schwabix-1311/aquaPCB/fab/aquaPCB-bom-jlc.csv

Comment | Designator | Footprint | LCSC Part #
4u7 50V | C2,C3 | C_1206_3216Metric | C29823
100n | C4,C5,C12,C13,C20,C21,C22,C23 | C_0805_2012Metric | C49678
10n | C6 | C_0805_2012Metric | C1710
47p | C7 | C_0805_2012Metric | C14857
47u | C8,C9 | C_1206_3216Metric | C96123
10u | C10,C11,C18,C19,C24,C25,C27,C28 | C_0805_2012Metric | C15850
BZT52C15 | D1 | D_SOD-123 | C173427
SMBJ33A | D2 | D_SMB | C78419
PWR | D3 | LED_0805_2012Metric | C84256
SS54 | D4,D6,D8,D10,D12,D14,D16 | D_SMA | C22452
3V3 | D5 | LED_0805_2012Metric | C2297
GPIO18 | D7 | LED_0805_2012Metric | C2297
PCA#1 ch15 | D9 | LED_0805_2012Metric | C2297
PCA#1 ch14 | D11 | LED_0805_2012Metric | C2297
GPIO19 | D13 | LED_0805_2012Metric | C2297
PCA#1 ch13 | D15 | LED_0805_2012Metric | C2297
PCA#1 ch12 | D17 | LED_0805_2012Metric | C2297
BAT54S | D26,D27,D28,D29,D30,D31,D32,D33,D34,D35,D36 | SOT-23 | C12765
10A | F1 | Littelfuse_OMNI-BLOK_154 | C206921
PTC 1.1A | F2 | Fuse_1206_3216Metric | C71465
10uH 4.8A | L1 | L_TDK_SLF12565 | C138303
AOD4184A | Q1,Q2,Q3,Q4,Q5,Q6 | TO-252-2 | C99124
DMP4010SK3Q | Q10 | TO-252-2 | C5359358
10k | R1,R2,R8,R9,R10,R11,R12,R13,R15,R18,R21,R24,R27,R30,R50,R52,R64,R66 | R_0805_2012Metric | C17414
150k | R3 | R_0805_2012Metric | C17470
12k | R4,R5 | R_0805_2012Metric | C17444
2k2 | R6 | R_0805_2012Metric | C17520
1k | R7,R16,R19,R22,R25,R28,R31,R55,R56,R57,R58,R59,R60 | R_0805_2012Metric | C17513
100 | R14,R17,R20,R23,R26,R29 | R_0805_2012Metric | C17408
4k7 | R44 | R_0805_2012Metric | C17673
20k | R51,R65,R67,R68 | R_0805_2012Metric | C4328
10k | R53,R54 | R_0603_1608Metric | C25804
4x100 | RN1,RN2,RN3,RN4,RN5,RN6,RN7,RN8 | R_Array_Convex_4x0603 | C25506
TPS54360B | U1 | TI_SO-PowerPAD-8_ThermalVias | C524806
AMS1117-3.3 | U2,U11 | SOT-223-3_TabPin2 | C6186
74HCT244D | U3 | SOIC-20W_7.5x12.8mm_P1.27mm | C5978
ADS1115IDGSR | U5 | TSSOP-10_3x3mm_P0.5mm | C37593
PCA9685PW | U7,U10 | TSSOP-28_4.4x9.7mm_P0.65mm | C2678753
74HCT244PW | U8,U9 | TSSOP-20_4.4x6.5mm_P0.65mm | C131088
