schwabix-1311/aquaPCB/fab/aquaPCB-print-1to1.pdf

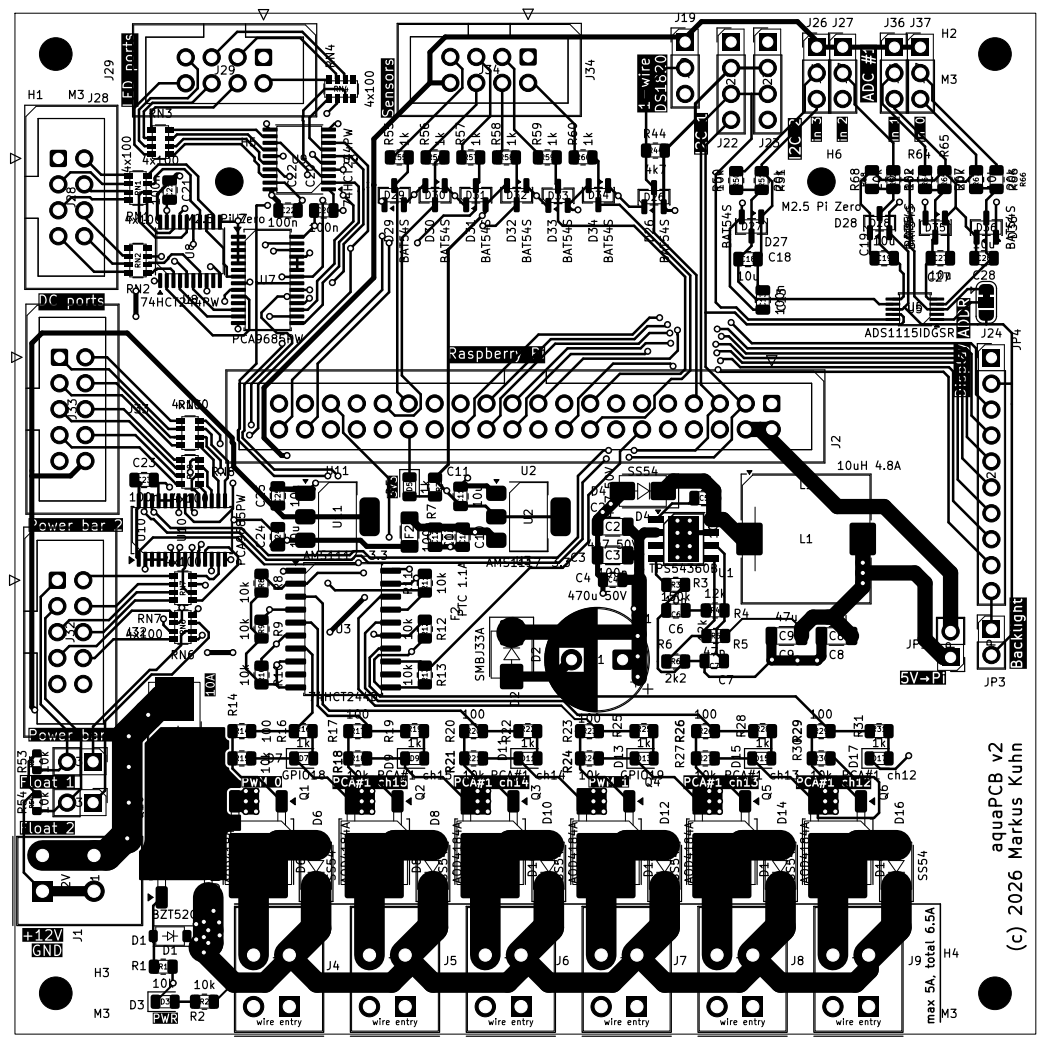
[picture p1: page 1]

max 5A, total 6.5A aquaPCB v2 (c) 2026 Markus Kuhn Q1 R1 R25 D15 R22 R2 R7 J34 R59 RN3 D10J31 H3 D13 R57 C21 D7 D12 U11 C20 Q5
