schwabix-1311/aquaPCB/kicad/aquaPCB.kicad_pcb

## KiCad design kicad/aquaPCB.kicad_pcb (2026-10-26)

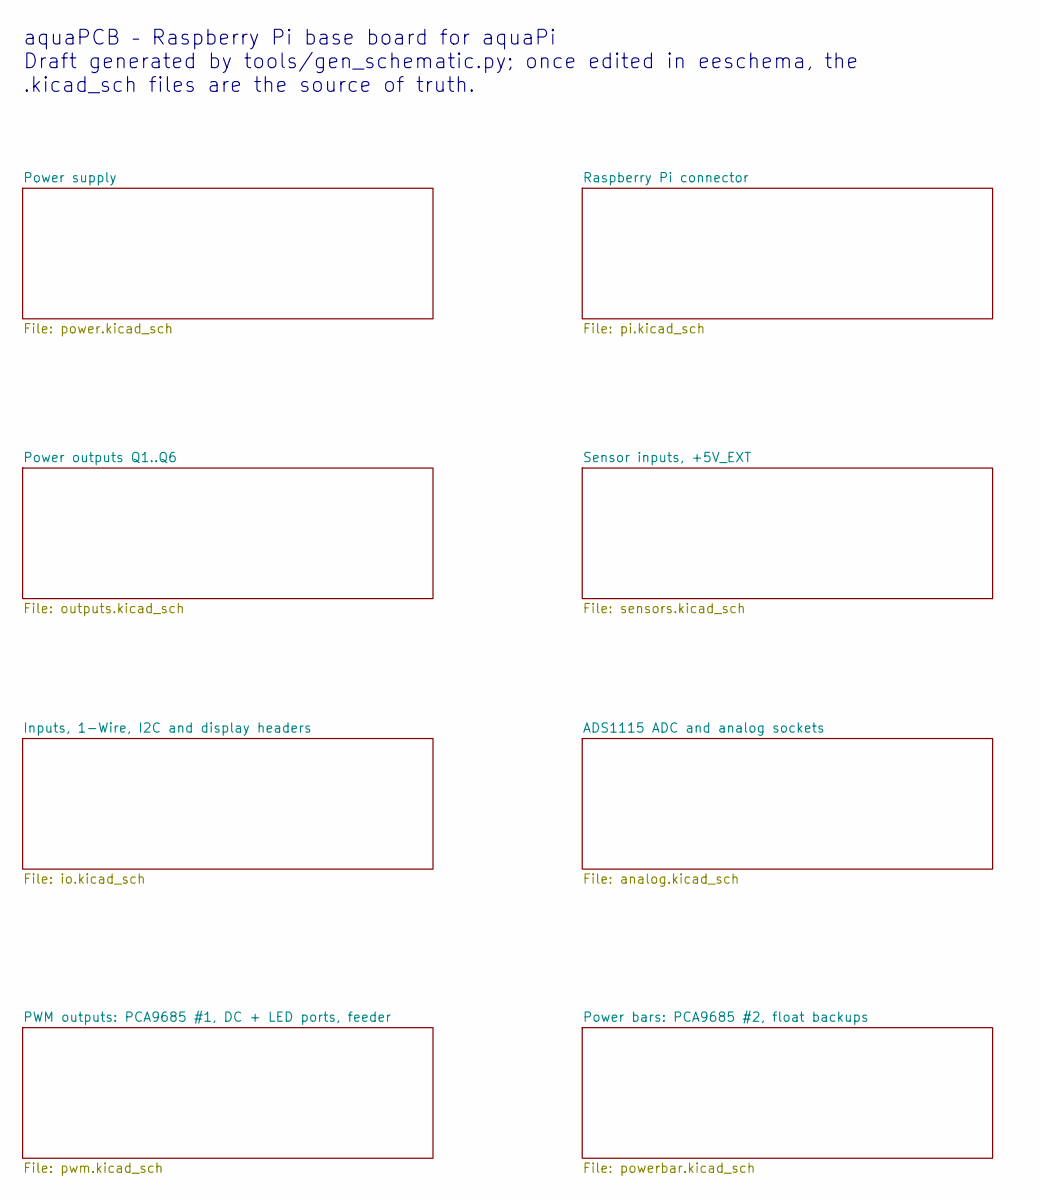
[picture p2: schematic aquaPCB.kicad_sch, aquaPCB – Overview]

Notes on the sheet:
aquaPCB – Raspberry Pi base board for aquaPi Draft generated by tools/gen_schematic.py; once edited in eeschema, the .kicad_sch files are the source of truth.

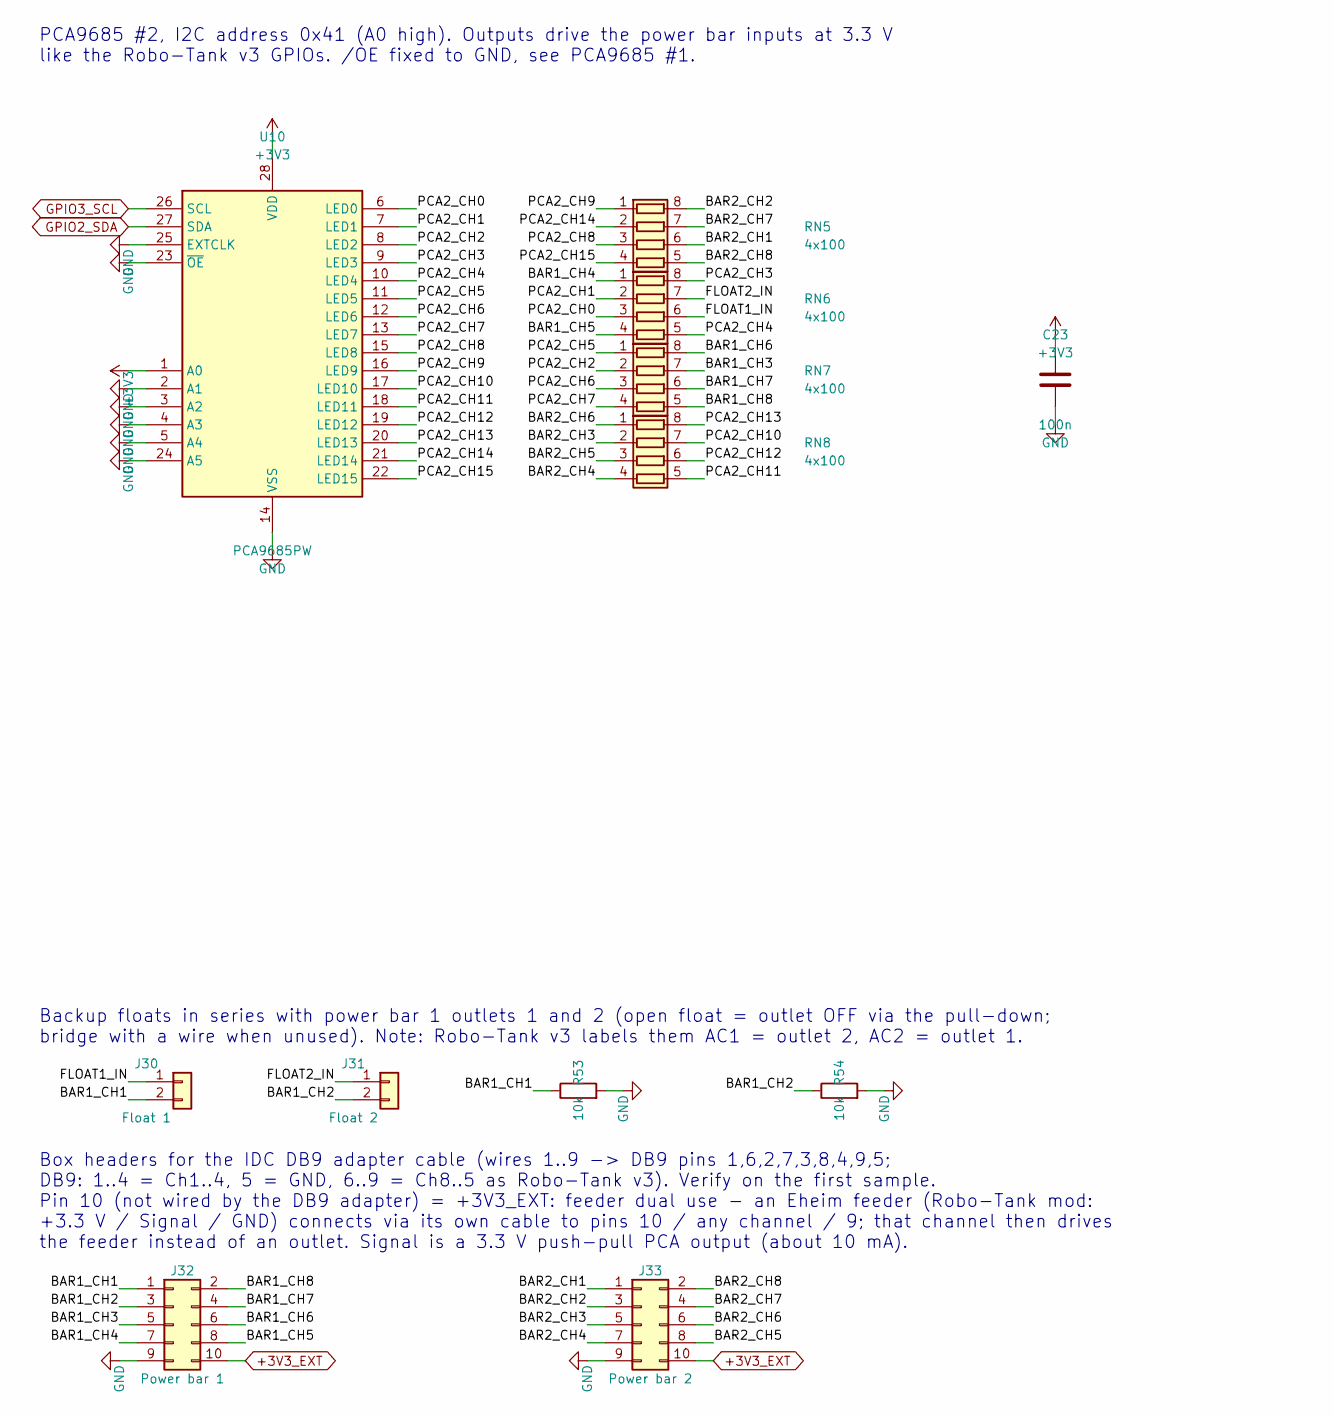
[picture p3: schematic powerbar.kicad_sch, aquaPCB – Power bars: PCA9685 #2, float backups]

Parts:
C23: 100n; C_0805_2012Metric; LCSC C49678
J30: Float 1; PinHeader_1x02_P2.54mm_Vertical
J31: Float 2; PinHeader_1x02_P2.54mm_Vertical
J32: Power bar 1; IDC-Header_2x05_P2.54mm_Vertical
J33: Power bar 2; IDC-Header_2x05_P2.54mm_Vertical
R53, R54: 10k; R_0603_1608Metric; LCSC C25804
RN5, RN6, RN7, RN8: 4x100; R_Array_Convex_4x0603; LCSC C25506
U10: PCA9685PW; TSSOP-28_4.4x9.7mm_P0.65mm; LCSC C2678753

Connections:
+3V3: C23.1, U10.1 (A0), U10.28 (VDD); also elsewhere on the board
+3V3_EXT: J32.10, J33.10; also elsewhere on the board
/Power bars: PCA9685 #2, float backups/BAR1_CH1: J30.2, J32.1, R53.1
/Power bars: PCA9685 #2, float backups/BAR1_CH2: J31.2, J32.3, R54.1
/Power bars: PCA9685 #2, float backups/BAR1_CH3: J32.5, RN7.7 (R2.2)
/Power bars: PCA9685 #2, float backups/BAR1_CH4: J32.7, RN6.1 (R1.1)
/Power bars: PCA9685 #2, float backups/BAR1_CH5: J32.8, RN6.4 (R4.1)
/Power bars: PCA9685 #2, float backups/BAR1_CH6: J32.6, RN7.8 (R1.2)
/Power bars: PCA9685 #2, float backups/BAR1_CH7: J32.4, RN7.6 (R3.2)
/Power bars: PCA9685 #2, float backups/BAR1_CH8: J32.2, RN7.5 (R4.2)
/Power bars: PCA9685 #2, float backups/BAR2_CH1: J33.1, RN5.6 (R3.2)
/Power bars: PCA9685 #2, float backups/BAR2_CH2: J33.3, RN5.8 (R1.2)
/Power bars: PCA9685 #2, float backups/BAR2_CH3: J33.5, RN8.2 (R2.1)
/Power bars: PCA9685 #2, float backups/BAR2_CH4: J33.7, RN8.4 (R4.1)
/Power bars: PCA9685 #2, float backups/BAR2_CH5: J33.8, RN8.3 (R3.1)
/Power bars: PCA9685 #2, float backups/BAR2_CH6: J33.6, RN8.1 (R1.1)
/Power bars: PCA9685 #2, float backups/BAR2_CH7: J33.4, RN5.7 (R2.2)
/Power bars: PCA9685 #2, float backups/BAR2_CH8: J33.2, RN5.5 (R4.2)
/Power bars: PCA9685 #2, float backups/FLOAT1_IN: J30.1, RN6.6 (R3.2)
/Power bars: PCA9685 #2, float backups/FLOAT2_IN: J31.1, RN6.7 (R2.2)
/Power bars: PCA9685 #2, float backups/PCA2_CH0: RN6.3 (R3.1), U10.6 (LED0)
/Power bars: PCA9685 #2, float backups/PCA2_CH1: RN6.2 (R2.1), U10.7 (LED1)
/Power bars: PCA9685 #2, float backups/PCA2_CH2: RN7.2 (R2.1), U10.8 (LED2)
/Power bars: PCA9685 #2, float backups/PCA2_CH3: RN6.8 (R1.2), U10.9 (LED3)
/Power bars: PCA9685 #2, float backups/PCA2_CH4: RN6.5 (R4.2), U10.10 (LED4)
/Power bars: PCA9685 #2, float backups/PCA2_CH5: RN7.1 (R1.1), U10.11 (LED5)
/Power bars: PCA9685 #2, float backups/PCA2_CH6: RN7.3 (R3.1), U10.12 (LED6)
/Power bars: PCA9685 #2, float backups/PCA2_CH7: RN7.4 (R4.1), U10.13 (LED7)
/Power bars: PCA9685 #2, float backups/PCA2_CH8: RN5.3 (R3.1), U10.15 (LED8)
/Power bars: PCA9685 #2, float backups/PCA2_CH9: RN5.1 (R1.1), U10.16 (LED9)
/Power bars: PCA9685 #2, float backups/PCA2_CH10: RN8.7 (R2.2), U10.17 (LED10)
/Power bars: PCA9685 #2, float backups/PCA2_CH11: RN8.5 (R4.2), U10.18 (LED11)
/Power bars: PCA9685 #2, float backups/PCA2_CH12: RN8.6 (R3.2), U10.19 (LED12)
/Power bars: PCA9685 #2, float backups/PCA2_CH13: RN8.8 (R1.2), U10.20 (LED13)
/Power bars: PCA9685 #2, float backups/PCA2_CH14: RN5.2 (R2.1), U10.21 (LED14)
/Power bars: PCA9685 #2, float backups/PCA2_CH15: RN5.4 (R4.1), U10.22 (LED15)
GND: C23.2, J32.9, J33.9, R53.2, R54.2, U10.2 (A1), U10.3 (A2), U10.4 (A3), U10.5 (A4), U10.14 (VSS), U10.23 (~OE), U10.24 (A5), U10.25 (EXTCLK); also elsewhere on the board
GPIO2_SDA: U10.27 (SDA); also elsewhere on the board
GPIO3_SCL: U10.26 (SCL); also elsewhere on the board

Notes on the sheet:
PCA9685 #2, I2C address 0x41 (A0 high). Outputs drive the power bar inputs at 3.3 V like the Robo-Tank v3 GPIOs. /OE fixed to GND, see PCA9685 #1.
Backup floats in series with power bar 1 outlets 1 and 2 (open float = outlet OFF via the pull-down; bridge with a wire when unused). Note: Robo-Tank v3 labels them AC1 = outlet 2, AC2 = outlet 1.
Box headers for the IDC DB9 adapter cable (wires 1..9 -> DB9 pins 1,6,2,7,3,8,4,9,5; DB9: 1..4 = Ch1..4, 5 = GND, 6..9 = Ch8..5 as Robo-Tank v3). Verify on the first sample. Pin 10 (not wired by the DB9 adapter) = +3V3_EXT: feeder dual use - an Eheim feeder (Robo-Tank mod: +3.3 V / Signal / GND) co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

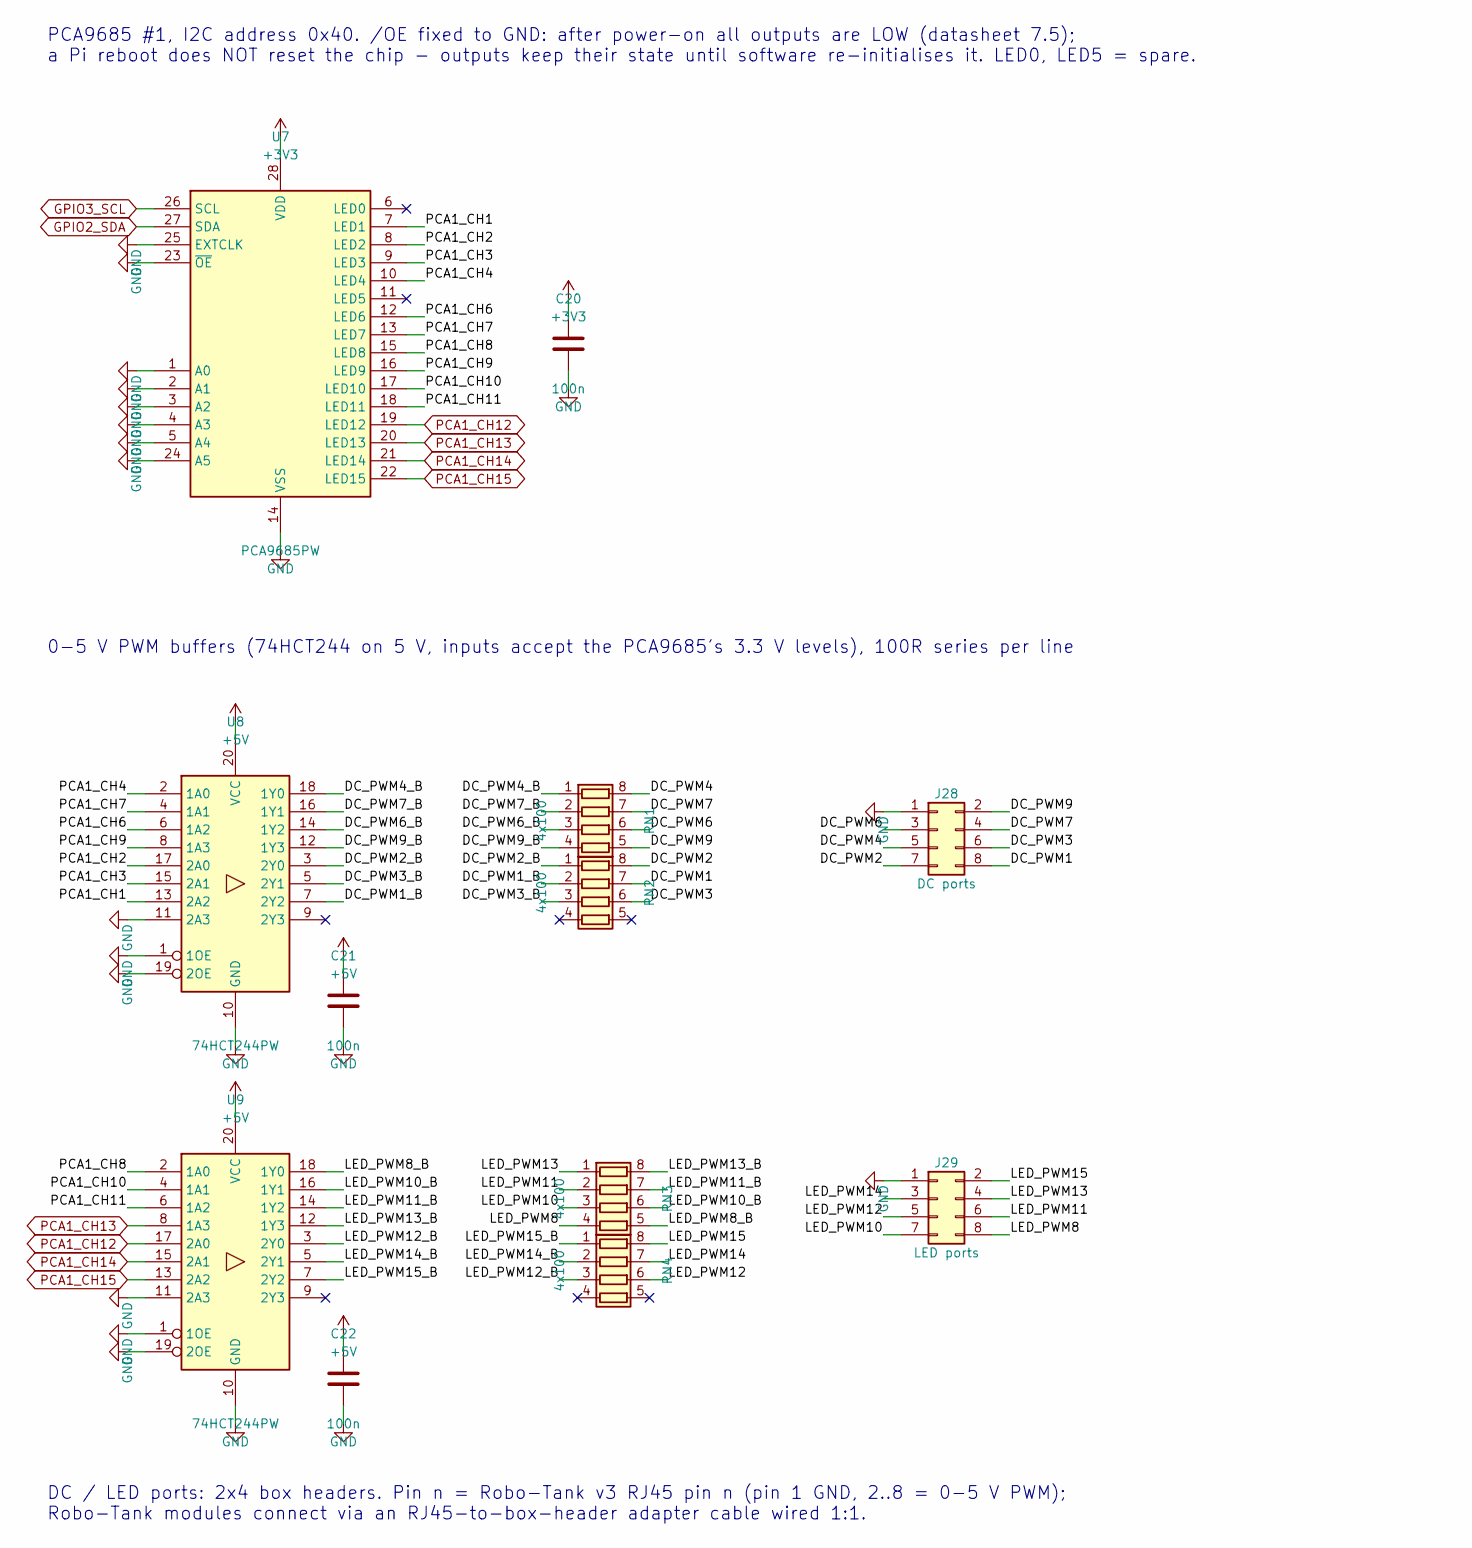
[picture p4: schematic pwm.kicad_sch, aquaPCB – PWM outputs: PCA9685 #1, DC + LED ports, feeder]

Parts:
C20, C21, C22: 100n; C_0805_2012Metric; LCSC C49678
J28: DC ports; IDC-Header_2x04_P2.54mm_Vertical
J29: LED ports; IDC-Header_2x04_P2.54mm_Vertical
RN1, RN2, RN3, RN4: 4x100; R_Array_Convex_4x0603; LCSC C25506
U7: PCA9685PW; TSSOP-28_4.4x9.7mm_P0.65mm; LCSC C2678753
U8, U9: 74HCT244PW; TSSOP-20_4.4x6.5mm_P0.65mm; LCSC C131088

Connections:
+3V3: C20.1, U7.28 (VDD); also elsewhere on the board
+5V: C21.1, C22.1, U8.20 (VCC), U9.20 (VCC); also elsewhere on the board
/PWM outputs: PCA9685 #1, DC + LED ports, feeder/DC_PWM1: J28.8, RN2.7 (R2.2)
/PWM outputs: PCA9685 #1, DC + LED ports, feeder/DC_PWM1_B: RN2.2 (R2.1), U8.7 (2Y2)
/PWM outputs: PCA9685 #1, DC + LED ports, feeder/DC_PWM2: J28.7, RN2.8 (R1.2)
/PWM outputs: PCA9685 #1, DC + LED ports, feeder/DC_PWM2_B: RN2.1 (R1.1), U8.3 (2Y0)
/PWM outputs: PCA9685 #1, DC + LED ports, feeder/DC_PWM3: J28.6, RN2.6 (R3.2)
/PWM outputs: PCA9685 #1, DC + LED ports, feeder/DC_PWM3_B: RN2.3 (R3.1), U8.5 (2Y1)
/PWM outputs: PCA9685 #1, DC + LED ports, feeder/DC_PWM4: J28.5, RN1.8 (R1.2)
/PWM outputs: PCA9685 #1, DC + LED ports, feeder/DC_PWM4_B: RN1.1 (R1.1), U8.18 (1Y0)
/PWM outputs: PCA9685 #1, DC + LED ports, feeder/DC_PWM6: J28.3, RN1.6 (R3.2)
/PWM outputs: PCA9685 #1, DC + LED ports, feeder/DC_PWM6_B: RN1.3 (R3.1), U8.14 (1Y2)
/PWM outputs: PCA9685 #1, DC + LED ports, feeder/DC_PWM7: J28.4, RN1.7 (R2.2)
/PWM outputs: PCA9685 #1, DC + LED ports, feeder/DC_PWM7_B: RN1.2 (R2.1), U8.16 (1Y1)
/PWM outputs: PCA9685 #1, DC + LED ports, feeder/DC_PWM9: J28.2, RN1.5 (R4.2)
/PWM outputs: PCA9685 #1, DC + LED ports, feeder/DC_PWM9_B: RN1.4 (R4.1), U8.12 (1Y3)
/PWM outputs: PCA9685 #1, DC + LED ports, feeder/LED_PWM8: J29.8, RN3.4 (R4.1)
/PWM outputs: PCA9685 #1, DC + LED ports, feeder/LED_PWM8_B: RN3.5 (R4.2), U9.18 (1Y0)
/PWM outputs: PCA9685 #1, DC + LED ports, feeder/LED_PWM10: J29.7, RN3.3 (R3.1)
/PWM outputs: PCA9685 #1, DC + LED ports, feeder/LED_PWM10_B: RN3.6 (R3.2), U9.16 (1Y1)
/PWM outputs: PCA9685 #1, DC + LED ports, feeder/LED_PWM11: J29.6, RN3.2 (R2.1)
/PWM outputs: PCA9685 #1, DC + LED ports, feeder/LED_PWM11_B: RN3.7 (R2.2), U9.14 (1Y2)
/PWM outputs: PCA9685 #1, DC + LED ports, feeder/LED_PWM12: J29.5, RN4.6 (R3.2)
/PWM outputs: PCA9685 #1, DC + LED ports, feeder/LED_PWM12_B: RN4.3 (R3.1), U9.3 (2Y0)
/PWM outputs: PCA9685 #1, DC + LED ports, feeder/LED_PWM13: J29.4, RN3.1 (R1.1)
/PWM outputs: PCA9685 #1, DC + LED ports, feeder/LED_PWM13_B: RN3.8 (R1.2), U9.12 (1Y3)
/PWM outputs: PCA9685 #1, DC + LED ports, feeder/LED_PWM14: J29.3, RN4.7 (R2.2)
/PWM outputs: PCA9685 #1, DC + LED ports, feeder/LED_PWM14_B: RN4.2 (R2.1), U9.5 (2Y1)
/PWM outputs: PCA9685 #1, DC + LED ports, feeder/LED_PWM15: J29.2, RN4.8 (R1.2)
/PWM outputs: PCA9685 #1, DC + LED ports, feeder/LED_PWM15_B: RN4.1 (R1.1), U9.7 (2Y2)
/PWM outputs: PCA9685 #1, DC + LED ports, feeder/PCA1_CH1: U7.7 (LED1), U8.13 (2A2)
/PWM outputs: PCA9685 #1, DC + LED ports, feeder/PCA1_CH2: U7.8 (LED2), U8.17 (2A0)
/PWM outputs: PCA9685 #1, DC + LED ports, feeder/PCA1_CH3: U7.9 (LED3), U8.15 (2A1)
/PWM outputs: PCA9685 #1, DC + LED ports, feeder/PCA1_CH4: U7.10 (LED4), U8.2 (1A0)
/PWM outputs: PCA9685 #1, DC + LED ports, feeder/PCA1_CH6: U7.12 (LED6), U8.6 (1A2)
/PWM outputs: PCA9685 #1, DC + LED ports, feeder/PCA1_CH7: U7.13 (LED7), U8.4 (1A1)
/PWM outputs: PCA9685 #1, DC + LED ports, feeder/PCA1_CH8: U7.15 (LED8), U9.2 (1A0)
/PWM outputs: PCA9685 #1, DC + LED ports, feeder/PCA1_CH9: U7.16 (LED9), U8.8 (1A3)
/PWM outputs: PCA9685 #1, DC + LED ports, feeder/PCA1_CH10: U7.17 (LED10), U9.4 (1A1)
/PWM outputs: PCA9685 #1, DC + LED ports, feeder/PCA1_CH11: U7.18 (LED11), U9.6 (1A2)
GND: C20.2, C21.2, C22.2, J28.1, J29.1, U7.1 (A0), U7.2 (A1), U7.3 (A2), U7.4 (A3), U7.5 (A4), U7.14 (VSS), U7.23 (~OE), U7.24 (A5), U7.25 (EXTCLK), U8.1 (1OE), U8.10 (GND), U8.11 (2A3), U8.19 (2OE), U9.1 (1OE), U9.10 (GND), U9.11 (2A3), U9.19 (2OE); also elsewhere on the board
GPIO2_SDA: U7.27 (SDA); also elsewhere on the board
GPIO3_SCL: U7.26 (SCL); also elsewhere on the board
PCA1_CH12: U7.19 (LED12), U9.17 (2A0); also elsewhere on the board
PCA1_CH13: U7.20 (LED13), U9.8 (1A3); also elsewhere on the board
PCA1_CH14: U7.21 (LED14), U9.15 (2A1); also elsewhere on the board
PCA1_CH15: U7.22 (LED15), U9.13 (2A2); also elsewhere on the board

Notes on the sheet:
0-5 V PWM buffers (74HCT244 on 5 V, inputs accept the PCA9685's 3.3 V levels), 100R series per line
DC / LED ports: 2x4 box headers. Pin n = Robo-Tank v3 RJ45 pin n (pin 1 GND, 2..8 = 0-5 V PWM); Robo-Tank modules connect via an RJ45-to-box-header adapter cable wired 1:1.
PCA9685 #1, I2C address 0x40. /OE fixed to GND: after power-on all outputs are LOW (datasheet 7.5); a Pi reboot does NOT reset the chip - outputs keep their state until software re-initialises it. LED0, LED5 = spare.

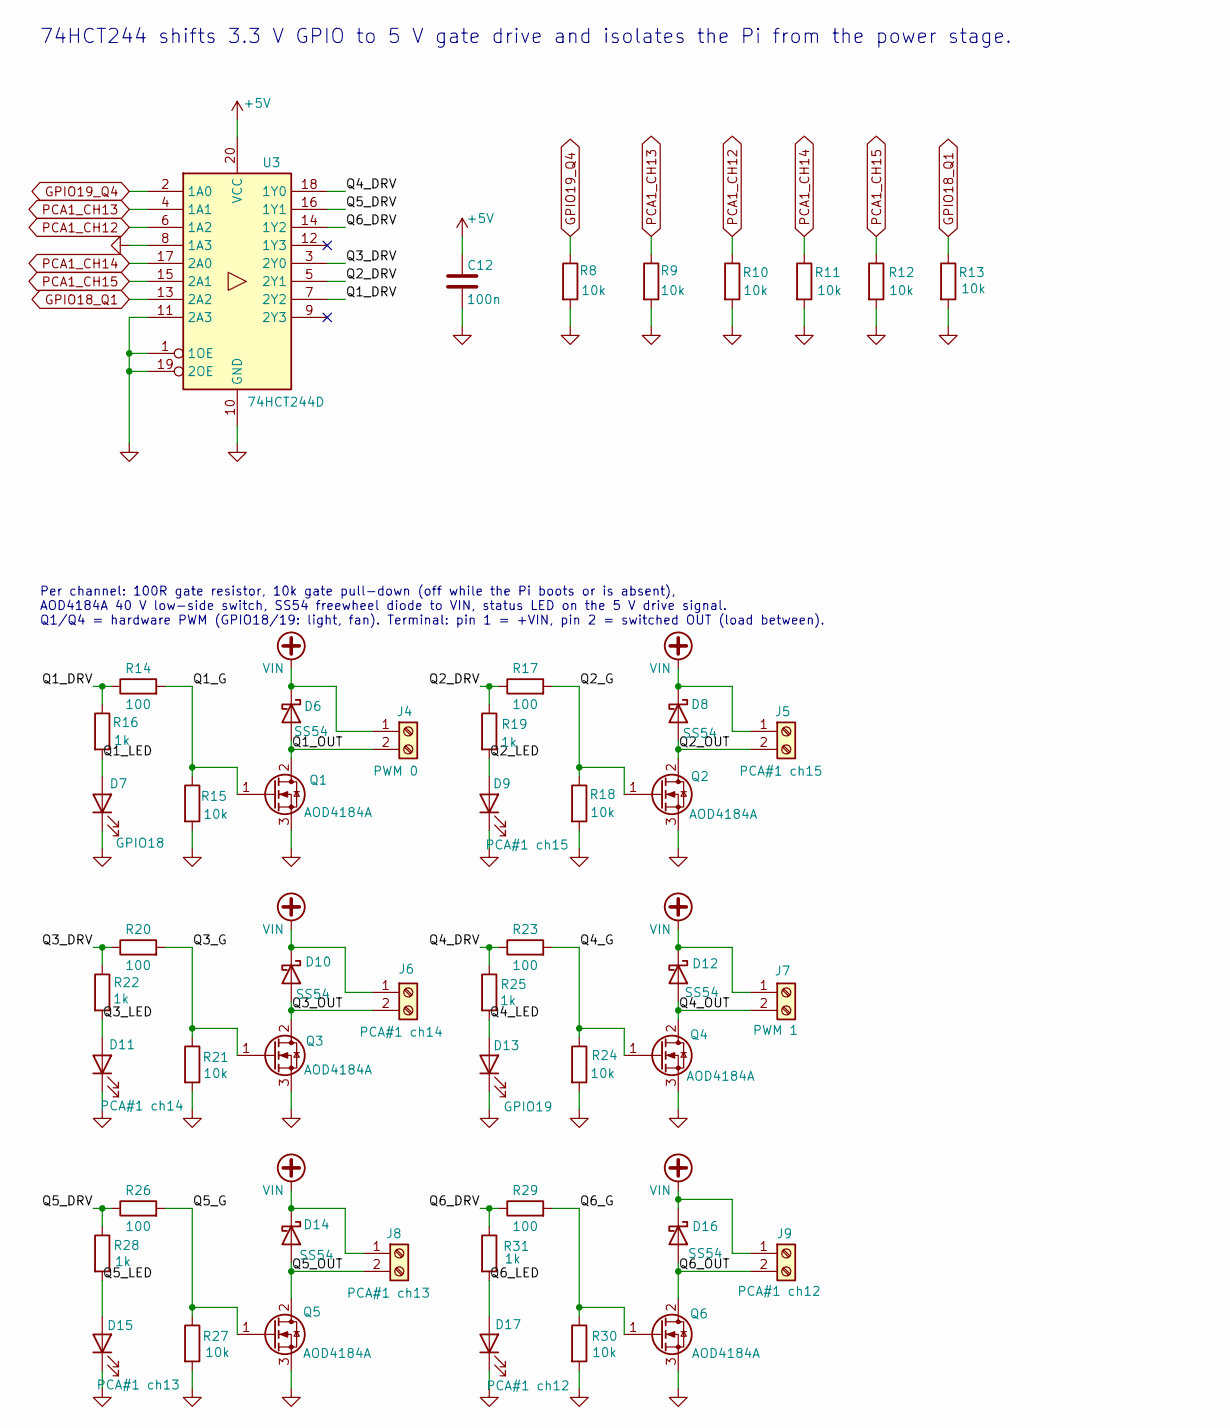
[picture p5: schematic outputs.kicad_sch, aquaPCB – Power outputs Q1..Q6]

Parts:
C12: 100n; C_0805_2012Metric; LCSC C49678
D6, D8, D10, D12, D14, D16: SS54; D_SMA; LCSC C22452
D7: GPIO18; LED_0805_2012Metric; LCSC C2297
D9: PCA#1 ch15; LED_0805_2012Metric; LCSC C2297
D11: PCA#1 ch14; LED_0805_2012Metric; LCSC C2297
D13: GPIO19; LED_0805_2012Metric; LCSC C2297
D15: PCA#1 ch13; LED_0805_2012Metric; LCSC C2297
D17: PCA#1 ch12; LED_0805_2012Metric; LCSC C2297
J4: PWM 0; TerminalBlock_Kangnex_WJ250B-3.5-02P_P3.50mm_Staggered; LCSC C8454
J5: PCA#1 ch15; TerminalBlock_Kangnex_WJ250B-3.5-02P_P3.50mm_Staggered; LCSC C8454
J6: PCA#1 ch14; TerminalBlock_Kangnex_WJ250B-3.5-02P_P3.50mm_Staggered; LCSC C8454
J7: PWM 1; TerminalBlock_Kangnex_WJ250B-3.5-02P_P3.50mm_Staggered; LCSC C8454
J8: PCA#1 ch13; TerminalBlock_Kangnex_WJ250B-3.5-02P_P3.50mm_Staggered; LCSC C8454
J9: PCA#1 ch12; TerminalBlock_Kangnex_WJ250B-3.5-02P_P3.50mm_Staggered; LCSC C8454
Q1, Q2, Q3, Q4, Q5, Q6: AOD4184A; TO-252-2; LCSC C99124
R8, R9, R10, R11, R12, R13, R15, R18, R21, R24, R27, R30: 10k; R_0805_2012Metric; LCSC C17414
R14, R17, R20, R23, R26, R29: 100; R_0805_2012Metric; LCSC C17408
R16, R19, R22, R25, R28, R31: 1k; R_0805_2012Metric; LCSC C17513
U3: 74HCT244D; SOIC-20W_7.5x12.8mm_P1.27mm; LCSC C5978

Connections:
+5V: C12.1, U3.20 (VCC); also elsewhere on the board
/Power outputs Q1..Q6/Q1_DRV: R14.1, R16.1, U3.7 (2Y2)
/Power outputs Q1..Q6/Q1_G: Q1.1 (G), R14.2, R15.1
/Power outputs Q1..Q6/Q1_LED: D7.2 (A), R16.2
/Power outputs Q1..Q6/Q1_OUT: D6.2 (A), J4.2, Q1.2 (D)
/Power outputs Q1..Q6/Q2_DRV: R17.1, R19.1, U3.5 (2Y1)
/Power outputs Q1..Q6/Q2_G: Q2.1 (G), R17.2, R18.1
/Power outputs Q1..Q6/Q2_LED: D9.2 (A), R19.2
/Power outputs Q1..Q6/Q2_OUT: D8.2 (A), J5.2, Q2.2 (D)
/Power outputs Q1..Q6/Q3_DRV: R20.1, R22.1, U3.3 (2Y0)
/Power outputs Q1..Q6/Q3_G: Q3.1 (G), R20.2, R21.1
/Power outputs Q1..Q6/Q3_LED: D11.2 (A), R22.2
/Power outputs Q1..Q6/Q3_OUT: D10.2 (A), J6.2, Q3.2 (D)
/Power outputs Q1..Q6/Q4_DRV: R23.1, R25.1, U3.18 (1Y0)
/Power outputs Q1..Q6/Q4_G: Q4.1 (G), R23.2, R24.1
/Power outputs Q1..Q6/Q4_LED: D13.2 (A), R25.2
/Power outputs Q1..Q6/Q4_OUT: D12.2 (A), J7.2, Q4.2 (D)
/Power outputs Q1..Q6/Q5_DRV: R26.1, R28.1, U3.16 (1Y1)
/Power outputs Q1..Q6/Q5_G: Q5.1 (G), R26.2, R27.1
/Power outputs Q1..Q6/Q5_LED: D15.2 (A), R28.2
/Power outputs Q1..Q6/Q5_OUT: D14.2 (A), J8.2, Q5.2 (D)
/Power outputs Q1..Q6/Q6_DRV: R29.1, R31.1, U3.14 (1Y2)
/Power outputs Q1..Q6/Q6_G: Q6.1 (G), R29.2, R30.1
/Power outputs Q1..Q6/Q6_LED: D17.2 (A), R31.2
/Power outputs Q1..Q6/Q6_OUT: D16.2 (A), J9.2, Q6.2 (D)
GND: C12.2, D7.1 (K), D9.1 (K), D11.1 (K), D13.1 (K), D15.1 (K), D17.1 (K), Q1.3 (S), Q2.3 (S), Q3.3 (S), Q4.3 (S), Q5.3 (S), Q6.3 (S), R8.2, R9.2, R10.2, R11.2, R12.2, R13.2, R15.2, R18.2, R21.2, R24.2, R27.2, R30.2, U3.1 (1OE), U3.8 (1A3), U3.10 (GND), U3.11 (2A3), U3.19 (2OE); also elsewhere on the board
GPIO18_Q1: R13.1, U3.13 (2A2); also elsewhere on the board
GPIO19_Q4: R8.1, U3.2 (1A0); also elsewhere on the board
PCA1_CH12: R10.1, U3.6 (1A2); also elsewhere on the board
PCA1_CH13: R9.1, U3.4 (1A1); also elsewhere on the board
PCA1_CH14: R11.1, U3.17 (2A0); also elsewhere on the board
PCA1_CH15: R12.1, U3.15 (2A1); also elsewhere on the board
VIN: D6.1 (K), D8.1 (K), D10.1 (K), D12.1 (K), D14.1 (K), D16.1 (K), J4.1, J5.1, J6.1, J7.1, J8.1, J9.1; also elsewhere on the board

Notes on the sheet:
Per channel: 100R gate resistor, 10k gate pull-down (off while the Pi boots or is absent), AOD4184A 40 V low-side switch, SS54 freewheel diode to VIN, status LED on the 5 V drive signal. Q1/Q4 = hardware PWM (GPIO18/19: light, fan). Terminal: pin 1 = +VIN, pin 2 = switched OUT (load between).
74HCT244 shifts 3.3 V GPIO to 5 V gate drive and isolates the Pi from the power stage.

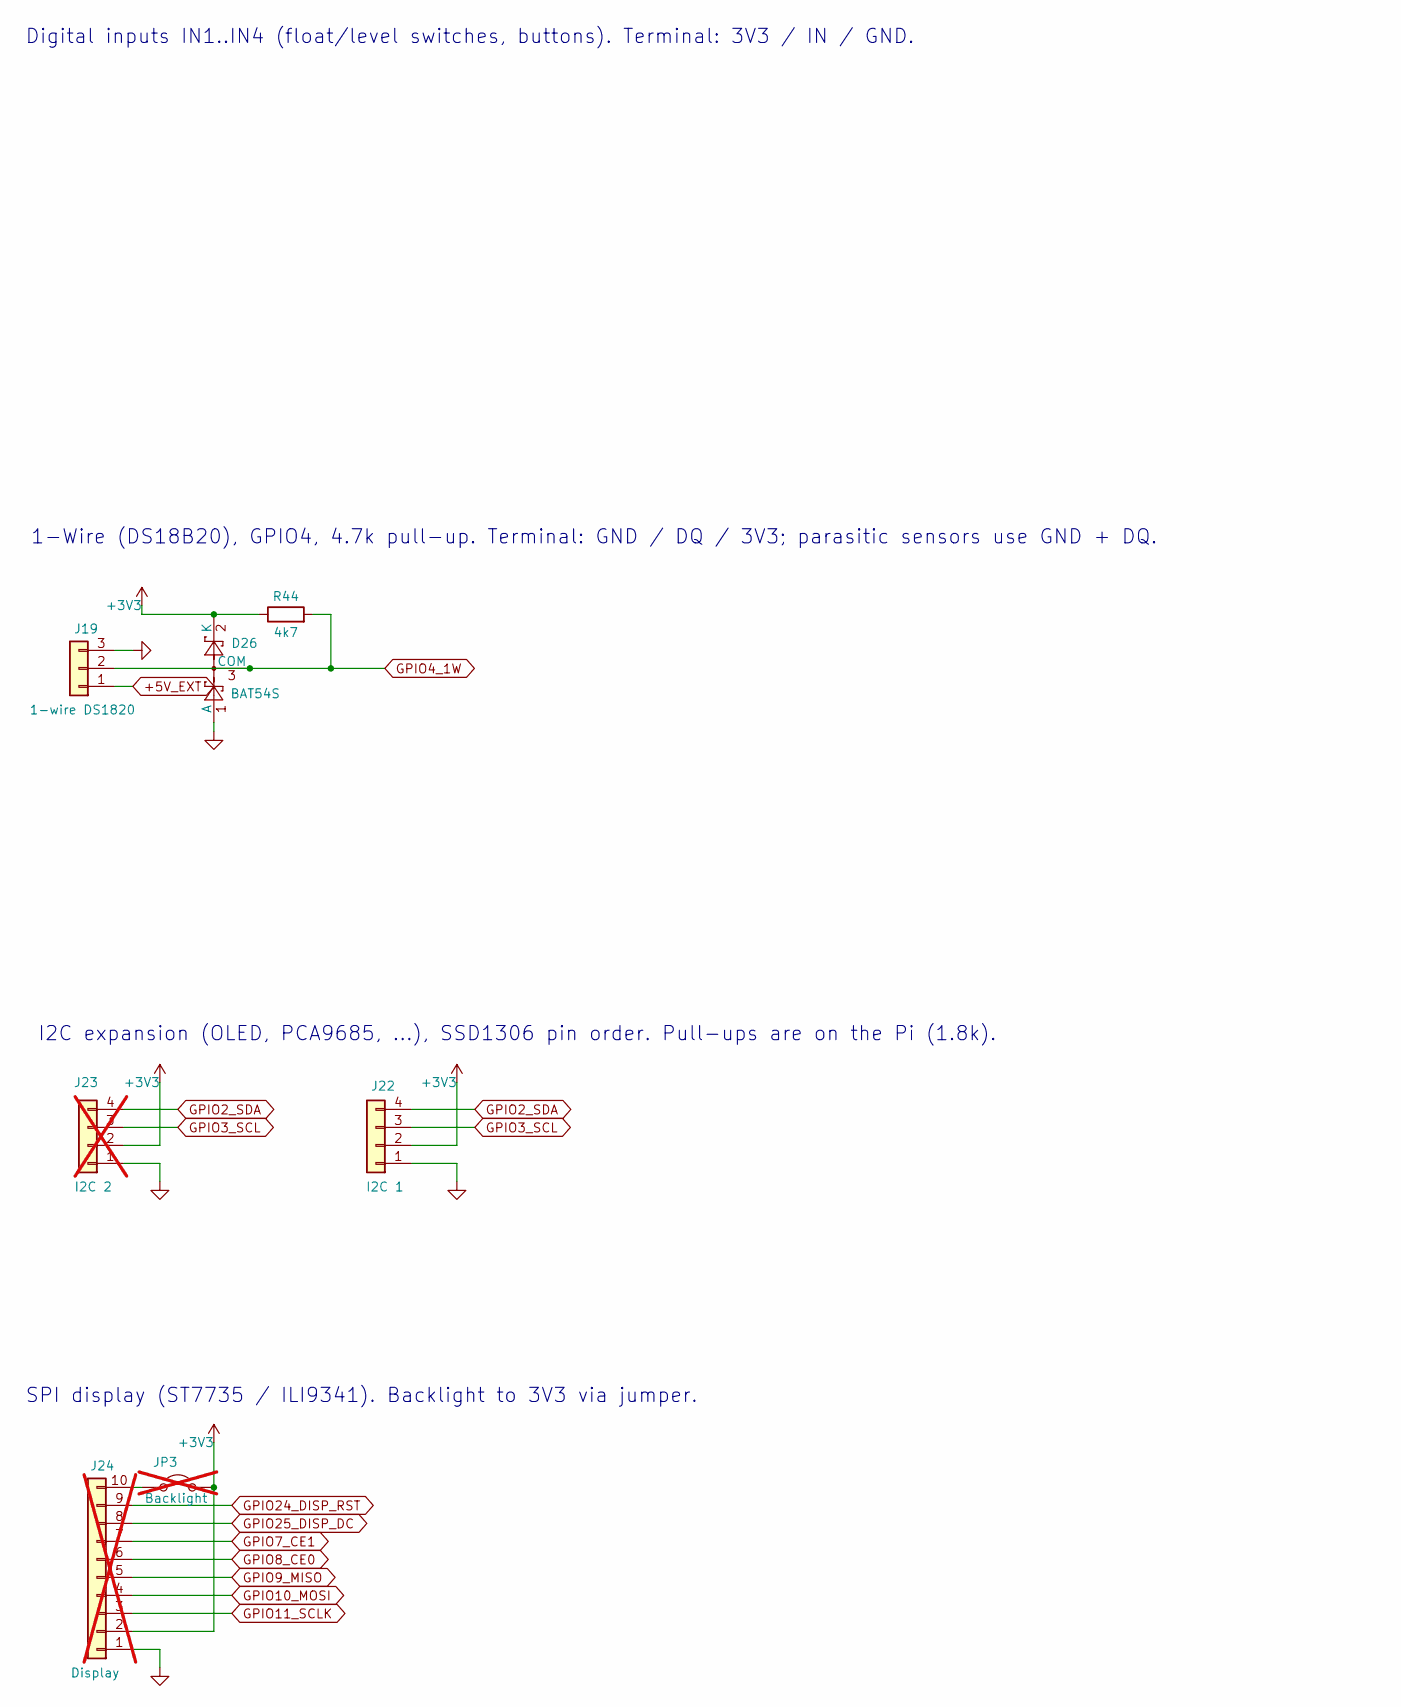
[picture p6: schematic io.kicad_sch, aquaPCB – Inputs, 1-Wire, I2C and display headers]

Parts:
D26: BAT54S; SOT-23; LCSC C12765
J19: 1-wire DS1820; PinHeader_1x03_P2.54mm_Vertical
J22: I2C 1; PinHeader_1x04_P2.54mm_Vertical
J23: I2C 2; PinHeader_1x04_P2.54mm_Vertical; not fitted
J24: Display; PinHeader_1x10_P2.54mm_Vertical; not fitted
JP3: Backlight; PinHeader_1x02_P2.54mm_Vertical; not fitted
R44: 4k7; R_0805_2012Metric; LCSC C17673

Connections:
+3V3: D26.2 (K), J22.2, J23.2, J24.2, JP3.2 (B), R44.1; also elsewhere on the board
+5V_EXT: J19.1; also elsewhere on the board
GND: D26.1 (A), J19.3, J22.1, J23.1, J24.1; also elsewhere on the board
GPIO2_SDA: J22.4, J23.4; also elsewhere on the board
GPIO3_SCL: J22.3, J23.3; also elsewhere on the board
GPIO4_1W: D26.3 (COM), J19.2, R44.2; also elsewhere on the board
GPIO7_CE1: J24.7; also elsewhere on the board
GPIO8_CE0: J24.6; also elsewhere on the board
GPIO9_MISO: J24.5; also elsewhere on the board
GPIO10_MOSI: J24.4; also elsewhere on the board
GPIO11_SCLK: J24.3; also elsewhere on the board
GPIO24_DISP_RST: J24.9; also elsewhere on the board
GPIO25_DISP_DC: J24.8; also elsewhere on the board
unnamed: J24.10, JP3.1 (A)

Notes on the sheet:
I2C expansion (OLED, PCA9685, ...), SSD1306 pin order. Pull-ups are on the Pi (1.8k).
1-Wire (DS18B20), GPIO4, 4.7k pull-up. Terminal: GND / DQ / 3V3; parasitic sensors use GND + DQ.
Digital inputs IN1..IN4 (float/level switches, buttons). Terminal: 3V3 / IN / GND.
SPI display (ST7735 / ILI9341). Backlight to 3V3 via jumper.

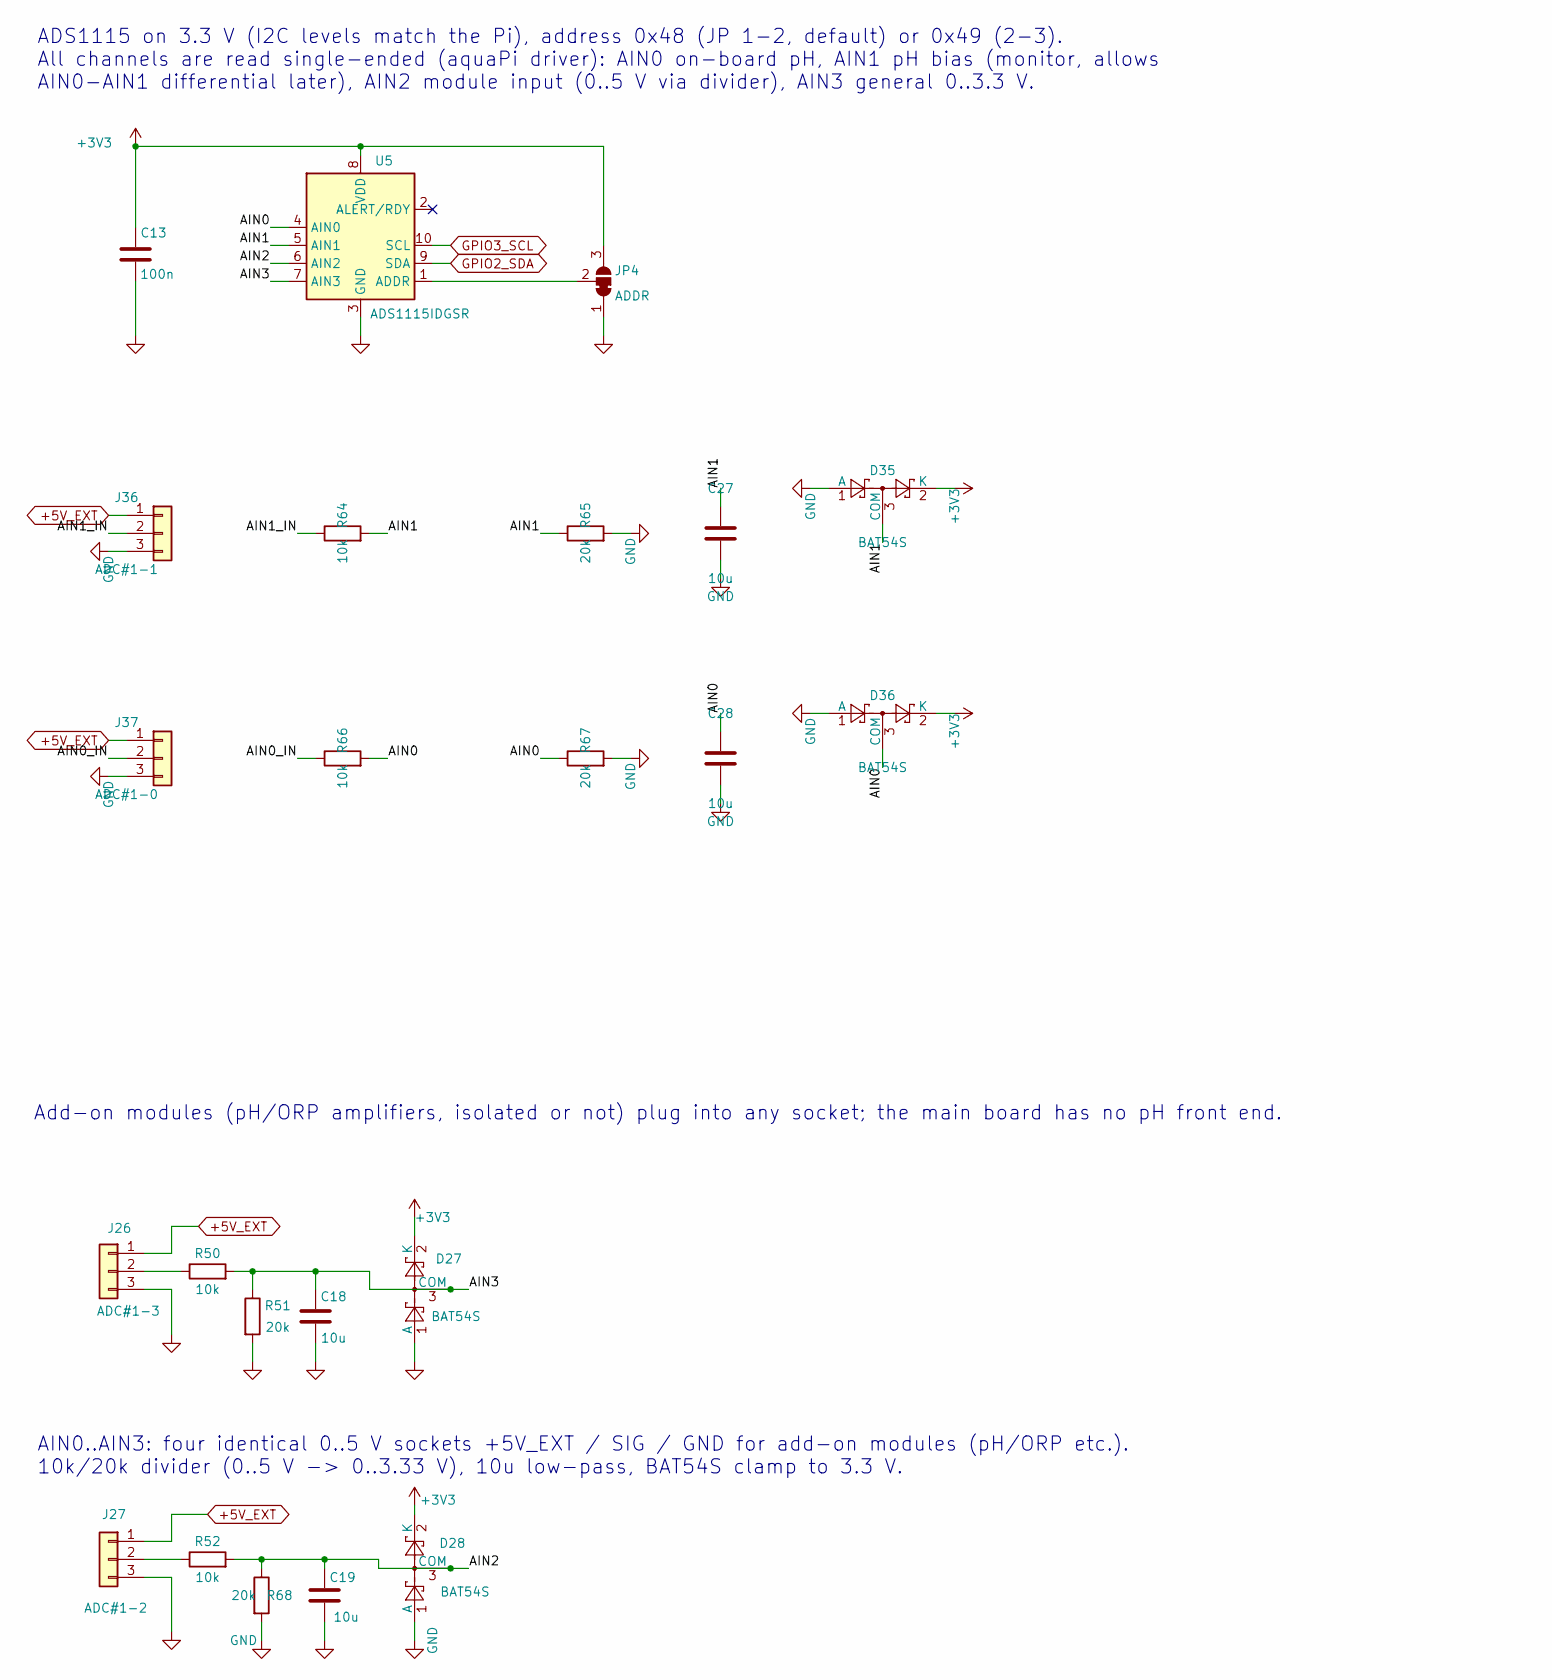
[picture p7: schematic analog.kicad_sch, aquaPCB – ADS1115 ADC and pH amplifier]

Parts:
C13: 100n; C_0805_2012Metric; LCSC C49678
C18, C19, C27, C28: 10u; C_0805_2012Metric; LCSC C15850
D27, D28, D35, D36: BAT54S; SOT-23; LCSC C12765
J26: ADC#1-3; PinHeader_1x03_P2.54mm_Vertical
J27: ADC#1-2; PinHeader_1x03_P2.54mm_Vertical
J36: ADC#1-1; PinHeader_1x03_P2.54mm_Vertical
J37: ADC#1-0; PinHeader_1x03_P2.54mm_Vertical
JP4: ADDR; SolderJumper-3_P1.3mm_Bridged12_RoundedPad1.0x1.5mm
R50, R52, R64, R66: 10k; R_0805_2012Metric; LCSC C17414
R51, R65, R67, R68: 20k; R_0805_2012Metric; LCSC C4328
U5: ADS1115IDGSR; TSSOP-10_3x3mm_P0.5mm; LCSC C37593

Connections:
+3V3: C13.1, D27.2 (K), D28.2 (K), D35.2 (K), D36.2 (K), JP4.3 (B), U5.8 (VDD); also elsewhere on the board
+5V_EXT: J26.1, J27.1, J36.1, J37.1; also elsewhere on the board
/ADS1115 ADC and analog sockets/AIN0: C28.1, D36.3 (COM), R66.2, R67.1, U5.4 (AIN0)
/ADS1115 ADC and analog sockets/AIN0_IN: J37.2, R66.1
/ADS1115 ADC and analog sockets/AIN1: C27.1, D35.3 (COM), R64.2, R65.1, U5.5 (AIN1)
/ADS1115 ADC and analog sockets/AIN1_IN: J36.2, R64.1
/ADS1115 ADC and analog sockets/AIN2: C19.1, D28.3 (COM), R52.2, R68.1, U5.6 (AIN2)
/ADS1115 ADC and analog sockets/AIN3: C18.1, D27.3 (COM), R50.2, R51.1, U5.7 (AIN3)
GND: C13.2, C18.2, C19.2, C27.2, C28.2, D27.1 (A), D28.1 (A), D35.1 (A), D36.1 (A), J26.3, J27.3, J36.3, J37.3, JP4.1 (A), R51.2, R65.2, R67.2, R68.2, U5.3 (GND); also elsewhere on the board
GPIO2_SDA: U5.9 (SDA); also elsewhere on the board
GPIO3_SCL: U5.10 (SCL); also elsewhere on the board
unnamed: J26.2, R50.1
unnamed: J27.2, R52.1
unnamed: JP4.2 (C), U5.1 (ADDR)

Notes on the sheet:
AIN0..AIN3: four identical 0..5 V sockets +5V_EXT / SIG / GND for add-on modules (pH/ORP etc.). 10k/20k divider (0..5 V -> 0..3.33 V), 10u low-pass, BAT54S clamp to 3.3 V.
Add-on modules (pH/ORP amplifiers, isolated or not) plug into any socket; the main board has no pH front end.
ADS1115 on 3.3 V (I2C levels match the Pi), address 0x48 (JP 1-2, default) or 0x49 (2-3). All channels are read single-ended (aquaPi driver): AIN0 on-board pH, AIN1 pH bias (monitor, allows AIN0-AIN1 differential later), AIN2 module input (0..5 V via divider), AIN3 general 0..3.3 V.
