schwabix-1311/aquaPCB/kicad/aquaPCB.kicad_pcb

## KiCad design kicad/aquaPCB.kicad_pcb (continued)

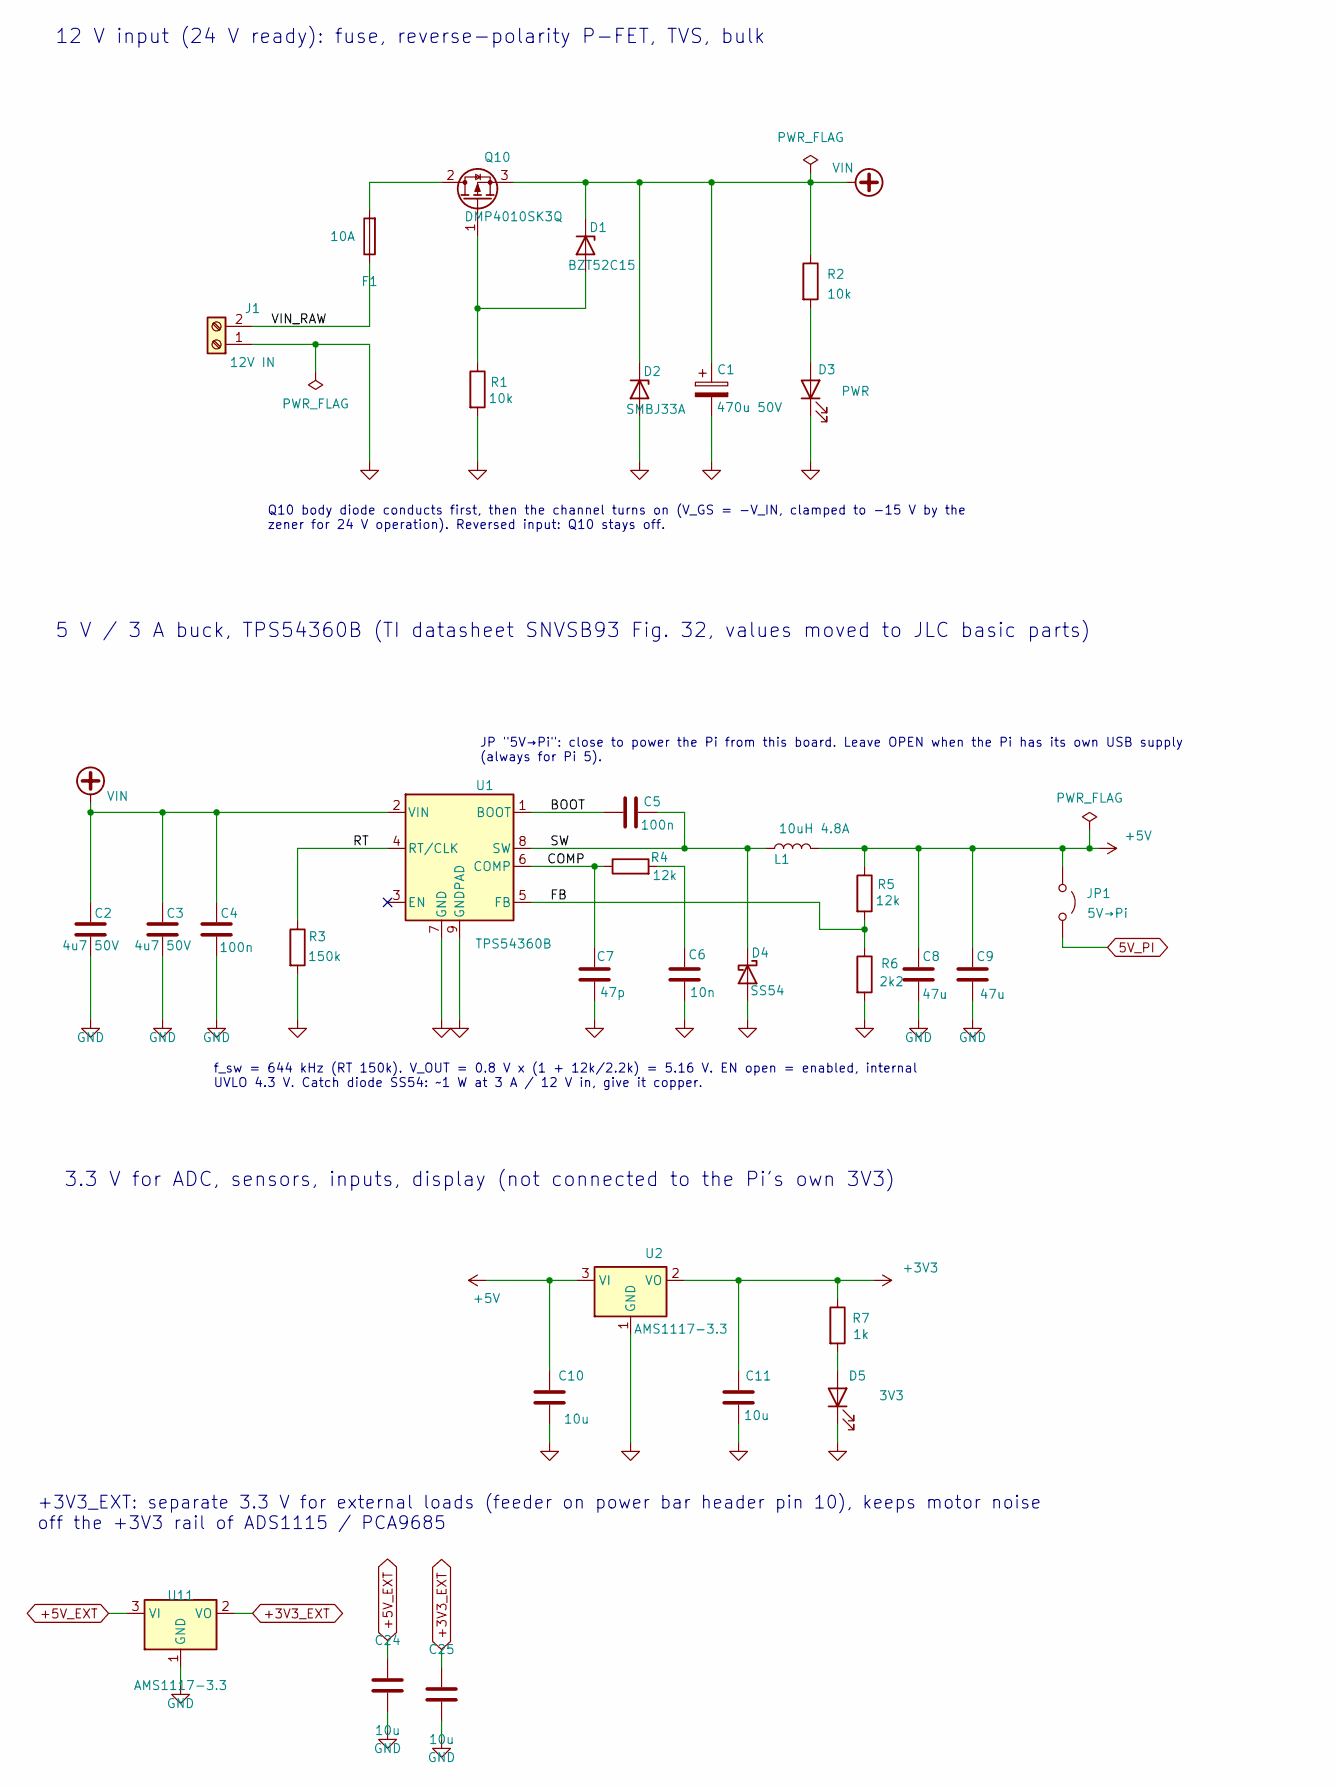
[picture p8: schematic power.kicad_sch, aquaPCB – Power supply]

Parts:
C1: 470u 50V; CP_Radial_D10.0mm_P5.00mm
C2, C3: 4u7 50V; C_1206_3216Metric; LCSC C29823
C4, C5: 100n; C_0805_2012Metric; LCSC C49678
C6: 10n; C_0805_2012Metric; LCSC C1710
C7: 47p; C_0805_2012Metric; LCSC C14857
C8, C9: 47u; C_1206_3216Metric; LCSC C96123
C10, C11, C24, C25: 10u; C_0805_2012Metric; LCSC C15850
D1: BZT52C15; D_SOD-123; LCSC C173427
D2: SMBJ33A; D_SMB; LCSC C78419
D3: PWR; LED_0805_2012Metric; LCSC C84256
D4: SS54; D_SMA; LCSC C22452
D5: 3V3; LED_0805_2012Metric; LCSC C2297
F1: 10A; Littelfuse_OMNI-BLOK_154; LCSC C206921
J1: 12V IN; TerminalBlock_Kangnex_WJ250B-3.5-02P_P3.50mm_Staggered; LCSC C8454
JP1: 5V→Pi; PinHeader_1x02_P2.54mm_Vertical
L1: 10uH 4.8A; L_TDK_SLF12565; LCSC C138303
Q10: DMP4010SK3Q; TO-252-2; LCSC C5359358
R1, R2: 10k; R_0805_2012Metric; LCSC C17414
R3: 150k; R_0805_2012Metric; LCSC C17470
R4, R5: 12k; R_0805_2012Metric; LCSC C17444
R6: 2k2; R_0805_2012Metric; LCSC C17520
R7: 1k; R_0805_2012Metric; LCSC C17513
U1: TPS54360B; TI_SO-PowerPAD-8_ThermalVias; LCSC C524806
U2, U11: AMS1117-3.3; SOT-223-3_TabPin2; LCSC C6186

Connections:
5V_PI: JP1.2 (B); also elsewhere on the board
+3V3: C11.1, R7.1, U2.2 (VO); also elsewhere on the board
+3V3_EXT: C25.1, U11.2 (VO); also elsewhere on the board
+5V: C8.1, C9.1, C10.1, JP1.1 (A), L1.2, R5.1, U2.3 (VI); also elsewhere on the board
+5V_EXT: C24.1, U11.3 (VI); also elsewhere on the board
/Power supply/BOOT: C5.1, U1.1 (BOOT)
/Power supply/COMP: C7.1, R4.1, U1.6 (COMP)
/Power supply/FB: R5.2, R6.1, U1.5 (FB)
/Power supply/RT: R3.1, U1.4 (RT/CLK)
/Power supply/SW: C5.2, D4.1 (K), L1.1, U1.8 (SW)
/Power supply/VIN_RAW: F1.1, J1.2
GND: C1.2, C2.2, C3.2, C4.2, C6.2, C7.2, C8.2, C9.2, C10.2, C11.2, C24.2, C25.2, D2.2 (A), D3.1 (K), D4.2 (A), D5.1 (K), J1.1, R1.2, R3.2, R6.2, U1.7 (GND), U1.9 (GNDPAD), U2.1 (GND), U11.1 (GND); also elsewhere on the board
unnamed: C6.1, R4.2
unnamed: D1.2 (A), Q10.1 (G), R1.1
unnamed: D3.2 (A), R2.2
unnamed: D5.2 (A), R7.2
unnamed: F1.2, Q10.2 (D)
VIN: C1.1, C2.1, C3.1, C4.1, D1.1 (K), D2.1 (K), Q10.3 (S), R2.1, U1.2 (VIN); also elsewhere on the board

Notes on the sheet:
5 V / 3 A buck, TPS54360B (TI datasheet SNVSB93 Fig. 32, values moved to JLC basic parts)
f_sw = 644 kHz (RT 150k). V_OUT = 0.8 V x (1 + 12k/2.2k) = 5.16 V. EN open = enabled, internal UVLO 4.3 V. Catch diode SS54: ~1 W at 3 A / 12 V in, give it copper.
JP "5V→Pi": close to power the Pi from this board. Leave OPEN when the Pi has its own USB supply (always for Pi 5).
Q10 body diode conducts first, then the channel turns on (V_GS = -V_IN, clamped to -15 V by the zener for 24 V operation). Reversed input: Q10 stays off.
12 V input (24 V ready): fuse, reverse-polarity P-FET, TVS, bulk
3.3 V for ADC, sensors, inputs, display (not connected to the Pi's own 3V3)
+3V3_EXT: separate 3.3 V for external loads (feeder on power bar header pin 10), keeps motor noise off the +3V3 rail of ADS1115 / PCA9685

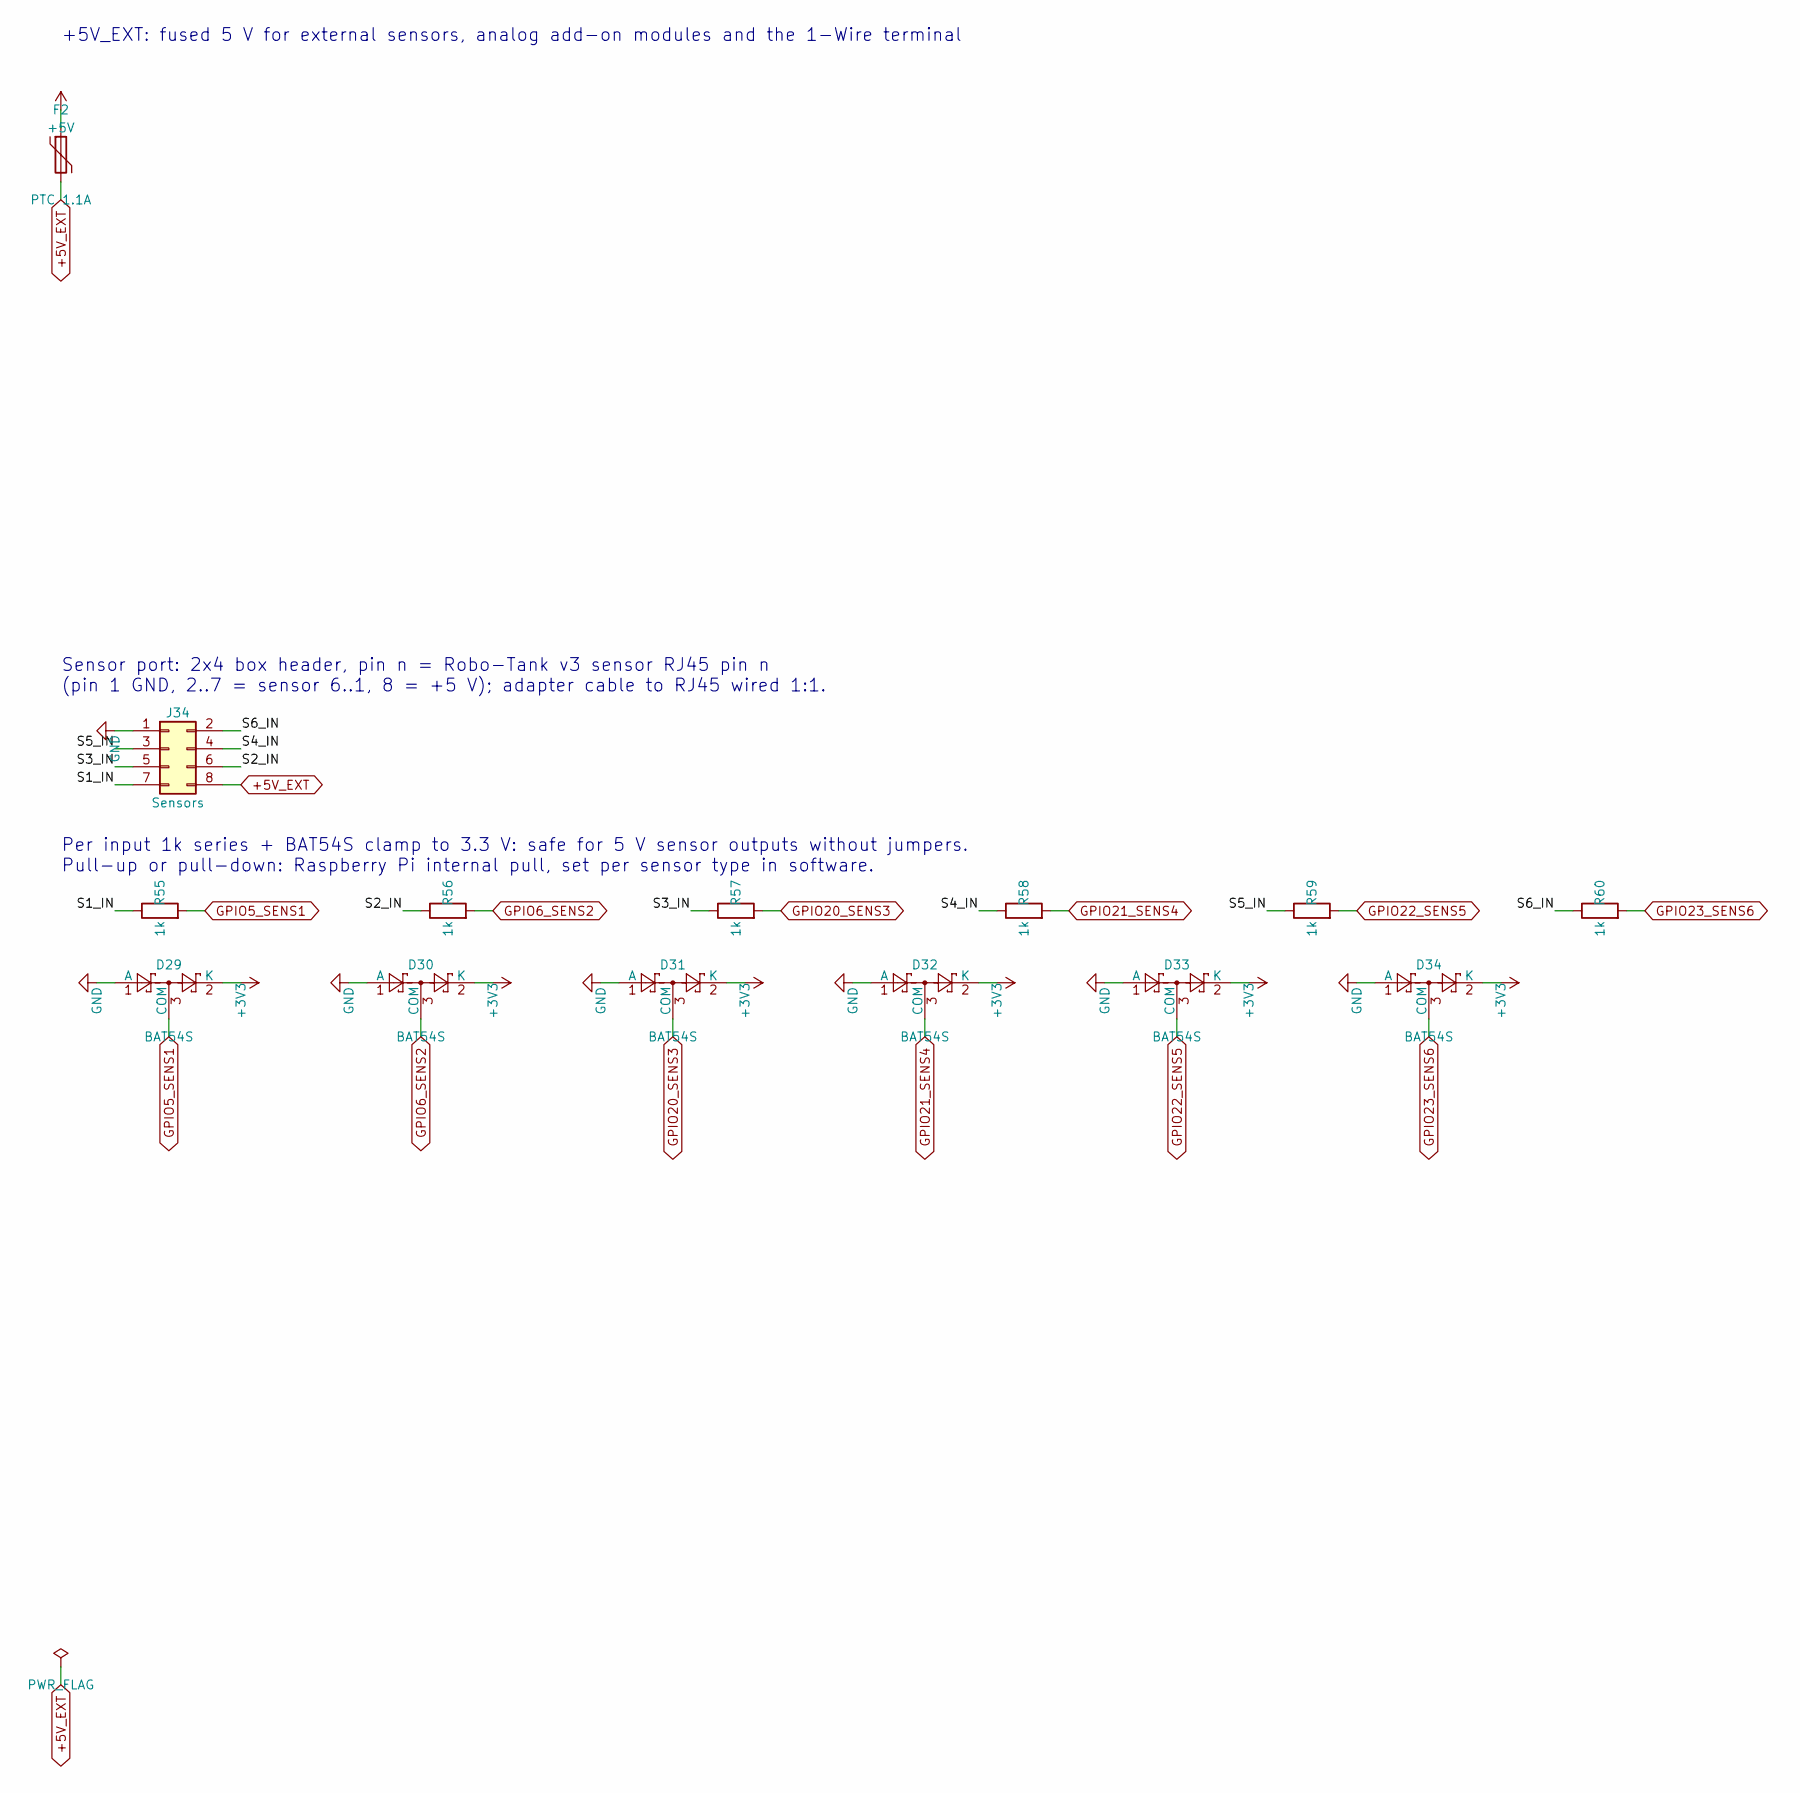
[picture p9: schematic sensors.kicad_sch, aquaPCB – Sensor inputs, +5V_EXT, 5 V I2C]

Parts:
D29, D30, D31, D32, D33, D34: BAT54S; SOT-23; LCSC C12765
F2: PTC 1.1A; Fuse_1206_3216Metric; LCSC C71465
J34: Sensors; IDC-Header_2x04_P2.54mm_Vertical
R55, R56, R57, R58, R59, R60: 1k; R_0805_2012Metric; LCSC C17513

Connections:
+3V3: D29.2 (K), D30.2 (K), D31.2 (K), D32.2 (K), D33.2 (K), D34.2 (K); also elsewhere on the board
+5V: F2.1; also elsewhere on the board
+5V_EXT: F2.2, J34.8; also elsewhere on the board
/Sensor inputs, +5V_EXT/S1_IN: J34.7, R55.1
/Sensor inputs, +5V_EXT/S2_IN: J34.6, R56.1
/Sensor inputs, +5V_EXT/S3_IN: J34.5, R57.1
/Sensor inputs, +5V_EXT/S4_IN: J34.4, R58.1
/Sensor inputs, +5V_EXT/S5_IN: J34.3, R59.1
/Sensor inputs, +5V_EXT/S6_IN: J34.2, R60.1
GND: D29.1 (A), D30.1 (A), D31.1 (A), D32.1 (A), D33.1 (A), D34.1 (A), J34.1; also elsewhere on the board
GPIO5_SENS1: D29.3 (COM), R55.2; also elsewhere on the board
GPIO6_SENS2: D30.3 (COM), R56.2; also elsewhere on the board
GPIO20_SENS3: D31.3 (COM), R57.2; also elsewhere on the board
GPIO21_SENS4: D32.3 (COM), R58.2; also elsewhere on the board
GPIO22_SENS5: D33.3 (COM), R59.2; also elsewhere on the board
GPIO23_SENS6: D34.3 (COM), R60.2; also elsewhere on the board

Notes on the sheet:
+5V_EXT: fused 5 V for external sensors, analog add-on modules and the 1-Wire terminal
Sensor port: 2x4 box header, pin n = Robo-Tank v3 sensor RJ45 pin n (pin 1 GND, 2..7 = sensor 6..1, 8 = +5 V); adapter cable to RJ45 wired 1:1.
Per input 1k series + BAT54S clamp to 3.3 V: safe for 5 V sensor outputs without jumpers. Pull-up or pull-down: Raspberry Pi internal pull, set per sensor type in software.

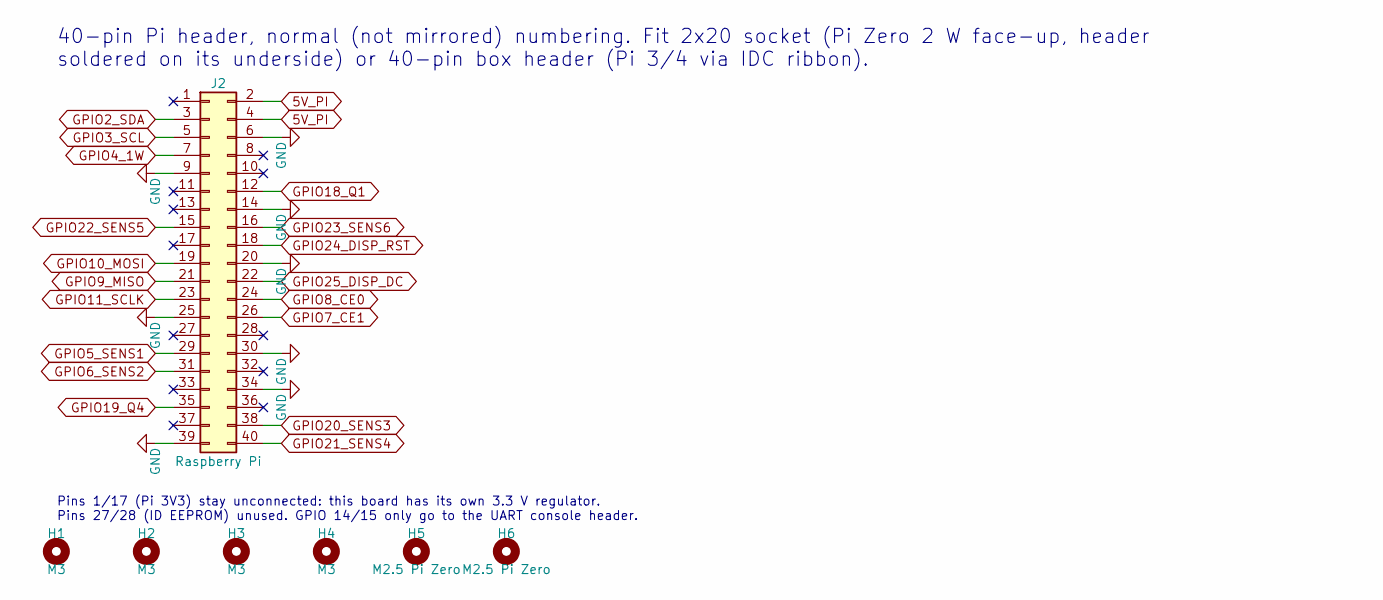
[picture p10: schematic pi.kicad_sch, aquaPCB – Raspberry Pi connector]

Parts:
H1, H2, H3, H4: M3; MountingHole_3.2mm_M3
H5, H6: M2.5 Pi Zero; MountingHole_2.7mm_M2.5
J2: Raspberry Pi; IDC-Header_2x20_P2.54mm_Vertical

Connections:
5V_PI: J2.2, J2.4; also elsewhere on the board
GND: J2.6, J2.9, J2.14, J2.20, J2.25, J2.30, J2.34, J2.39; also elsewhere on the board
GPIO2_SDA: J2.3; also elsewhere on the board
GPIO3_SCL: J2.5; also elsewhere on the board
GPIO4_1W: J2.7; also elsewhere on the board
GPIO5_SENS1: J2.29; also elsewhere on the board
GPIO6_SENS2: J2.31; also elsewhere on the board
GPIO7_CE1: J2.26; also elsewhere on the board
GPIO8_CE0: J2.24; also elsewhere on the board
GPIO9_MISO: J2.21; also elsewhere on the board
GPIO10_MOSI: J2.19; also elsewhere on the board
GPIO11_SCLK: J2.23; also elsewhere on the board
GPIO18_Q1: J2.12; also elsewhere on the board
GPIO19_Q4: J2.35; also elsewhere on the board
GPIO20_SENS3: J2.38; also elsewhere on the board
GPIO21_SENS4: J2.40; also elsewhere on the board
GPIO22_SENS5: J2.15; also elsewhere on the board
GPIO23_SENS6: J2.16; also elsewhere on the board
GPIO24_DISP_RST: J2.18; also elsewhere on the board
GPIO25_DISP_DC: J2.22; also elsewhere on the board

Notes on the sheet:
40-pin Pi header, normal (not mirrored) numbering. Fit 2x20 socket (Pi Zero 2 W face-up, header soldered on its underside) or 40-pin box header (Pi 3/4 via IDC ribbon).
Pins 1/17 (Pi 3V3) stay unconnected: this board has its own 3.3 V regulator. Pins 27/28 (ID EEPROM) unused. GPIO 14/15 only go to the UART console header.

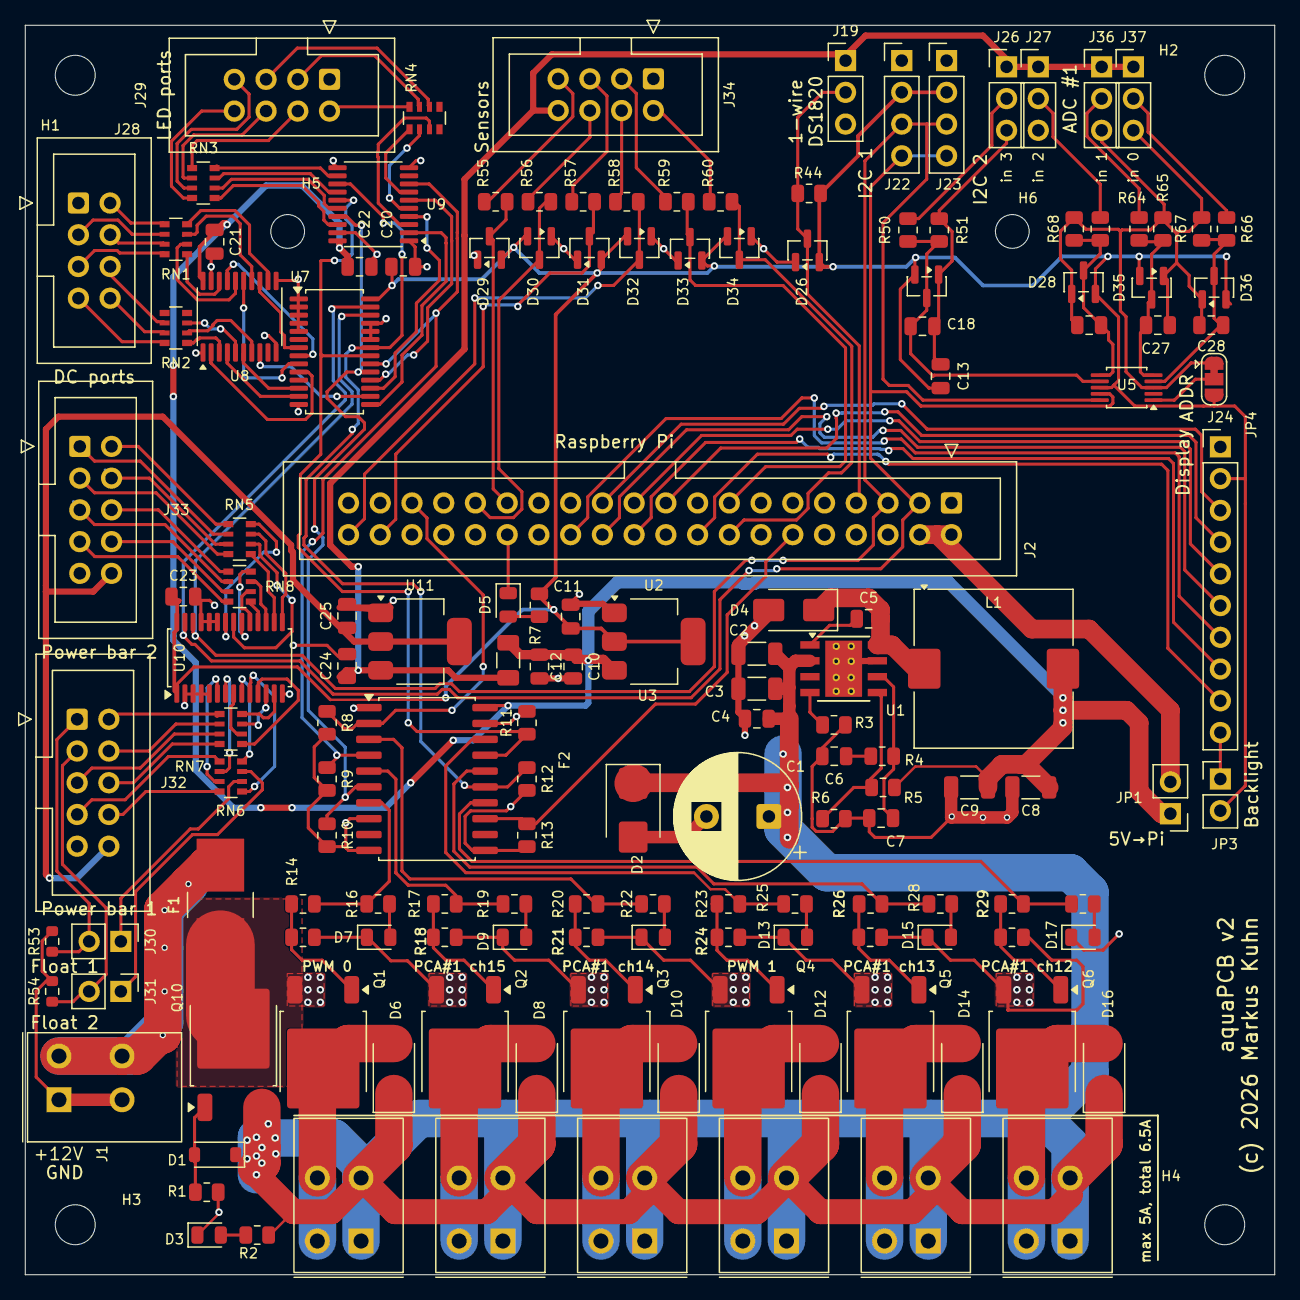
[picture p11: board aquaPCB.kicad_pcb from above]

Board: 2 copper layers, 100.0 x 100.0 mm, 158 parts (0 on the bottom side), 152 nets.
