schwabix-1311/aquaPCB/(commit log)

2026-09-29 aquaPCB: v1 specification and verified BOM
    Spec for a Raspberry Pi base board for aquaPi: 12 V supply, 6 power
    MOSFET outputs, 4 SSR driver outputs, 4 inputs, 1-Wire, ADS1115 with pH
    front end, I2C/SPI display headers. BOM with LCSC part numbers for JLC
    assembly and Reichelt numbers for hand-soldered parts, checked
    2026-09-29. Licensed CERN-OHL-S-2.0.
2026-09-29 kicad: first schematic draft, ERC clean
    Hierarchical KiCad 10 schematic (power, Pi connector, power outputs,
    SSR outputs, inputs/1-Wire/display, ADC/pH) generated from the pin map
    and BOM by tools/gen_schematic.py. Buck values follow TI's TPS54360B
    5 V example, moved to JLC basic parts (644 kHz, 5.16 V). Adds a project
    footprint for the Littelfuse OMNI-BLOK 154 fuse holder and syncs
    BOM.md quantities with the schematic.
    [analog.kicad_sch, aquaPCB.kicad_sch, io.kicad_sch, outputs.kicad_sch, pi.kicad_sch, power.kicad_sch, ssr.kicad_sch]
2026-09-29 kicad: single-ended pH front end, input for external pH module
    aquaPi's ADS1115 driver reads single-ended only. Bias the probe
    reference from a TL431 (PH_REF = 1.25 V) so AIN0 works single-ended
    with the offset removed by 2-point calibration; keep PH_REF on AIN1 for
    a later differential mode. Add 50 Hz filtering (1 nF input, 10k/10u
    after the buffer) and a +5V/SIG/GND terminal on AIN2 for the common
    pH amplifier modules. BOM and README updated.
    [analog.kicad_sch, aquaPCB.kicad_sch, io.kicad_sch, outputs.kicad_sch, pi.kicad_sch, power.kicad_sch, ssr.kicad_sch]
2026-09-29 kicad: minimise pH probe load, drop input capacitor
    The 1 nF on the high-impedance pH input had an insulation resistance
    (MLCC spec ~10 GOhm) far below the op-amp input (0.5 pA typ), so it
    dominated the probe load. The probe now only sees the TLV9062 input;
    50 Hz filtering stays after the buffer. Layout note: guard ring driven
    by PH_BUF around the input.
    [analog.kicad_sch, aquaPCB.kicad_sch, io.kicad_sch, outputs.kicad_sch, pi.kicad_sch, power.kicad_sch, ssr.kicad_sch]
2026-09-29 kicad: styroflex filter capacitor across the pH probe
    Polystyrene film leaks far less than an MLCC, so the input filter can
    stay without loading the probe: 2.2 nF from PH_IN to PH_REF, with the
    electrode resistance a 0.2..2 s filter against pump 50 Hz. Hand-soldered
    axial part from Reichelt; BOM, README and cost estimate updated.
    [analog.kicad_sch, aquaPCB.kicad_sch, io.kicad_sch, outputs.kicad_sch, pi.kicad_sch, power.kicad_sch, ssr.kicad_sch]
2026-09-29 README: layout rules for the high-impedance pH input
    Guard ring on PH_BUF, milled slots around the BNC centre and input pads,
    clean board: the PCB equivalent of the air-wired input of the
    hand-built controller.
2026-09-29 kicad: galvanically isolate the analog / pH section
    The tank water is tied to board GND through other sensors (DS18B20
    sleeve), so the biased pH reference electrode would carry a continuous
    DC current. Move ADS1115, pH buffer, TL431 and the AIN2/AIN3 terminals
    to an isolated domain: B0505S 1 W DC/DC + AMS1117 for ISO_3V3, ISO1540
    I2C isolator (side 2 on the Pi bus, side 1 on the ADS1115). Netlist
    checked: only the DC/DC and the ISO1540 cross the boundary. BOM, README
    and cost estimate (~45 EUR/board at 5) updated.
    [analog.kicad_sch, aquaPCB.kicad_sch, io.kicad_sch, outputs.kicad_sch, pi.kicad_sch, power.kicad_sch, ssr.kicad_sch]
2026-09-29 kicad: simpler non-isolated pH amplifier after review of the hand-built setup
    Nothing in the tank is grounded and ~0.1 pH stability is enough, so the
    galvanic isolation (B0505S + ISO1540) and the TL431 reference go. The
    on-board pH amplifier now mirrors the proven PH-4502C mod: 10 MOhm +
    6.8 nF styroflex input filter, TLV9062 buffer, bias 3V3/2 buffered,
    plus 1 MOhm in the reference line as ground-loop insurance. AIN2 is a
    module input for 5 V amplifier boards with a 10k/20k divider (0..5 V).
    BOM, README and cost (~41 EUR/board at 5, ~33 at 10) updated.
    [analog.kicad_sch, aquaPCB.kicad_sch, io.kicad_sch, outputs.kicad_sch, pi.kicad_sch, power.kicad_sch, ssr.kicad_sch]
2026-09-30 kicad: drop the third 1-Wire terminal
    Two terminals are enough for the bus (several sensors per terminal).
    Saves one AKL 101-03 (0.39 EUR/board) and board edge space.
    [analog.kicad_sch, aquaPCB.kicad_pcb, aquaPCB.kicad_sch, io.kicad_sch, outputs.kicad_sch, pi.kicad_sch, power.kicad_sch, ssr.kicad_sch]
2026-09-30 git: stop tracking KiCad local history and restore backups
    f617249 accidentally added kicad/.history (KiCad's local-history git
    repo, as an embedded repository) and two _restore_backup folders.
    Untrack them and ignore them from now on; the files stay on disk.
    [analog.kicad_sch, aquaPCB.kicad_sch, io.kicad_sch, outputs.kicad_sch, pi.kicad_sch, power.kicad_sch, ssr.kicad_sch]
2026-09-30 tools: retire the schematic generator
    The schematic is edited by hand now. gen_schematic.py refuses to
    overwrite existing .kicad_sch files unless --force is given; it
    overwrote hand edits once (f617249).
2026-09-30 kicad: restore the hand-edited schematic from KiCad local history
    f617249 overwrote the schematic that had been tidied by hand in
    eeschema (labels replaced by wires and junctions) with a regenerated
    draft and new symbol UUIDs. Restore all sheets and the project file
    from KiCad's local history snapshot eb84d42 (2026-09-30 14:45).
    Connectivity matches that snapshot; all 153 symbols link to the
    footprints in aquaPCB.kicad_pcb again. The third 1-Wire terminal (J21)
    is still in the schematic and has to be deleted in eeschema.
    [analog.kicad_sch, aquaPCB.kicad_sch, io.kicad_sch, outputs.kicad_sch, pi.kicad_sch, power.kicad_sch, ssr.kicad_sch]
2026-09-30 kicad: remove the third 1-Wire terminal (J21)
    Deleted in eeschema; connectivity otherwise unchanged (checked against
    the restored netlist).
    [io.kicad_sch]
2026-09-30 kicad: fix connections broken while tidying the schematic
    analog: AIN1 (U5.5) reconnected to PH_REF, AIN2 and AIN3 filter nodes
    reconnected to their clamps / ADC inputs (net labels), two dangling
    wire pieces removed. power: seven dangling wire stubs removed.
    ERC clean; connectivity equals the design of 7b8e8dd except the removed
    J21 and the (equivalent) swapped JP3 pins. Minimal text edits, the rest
    of the hand-edited drawing is untouched.
    [analog.kicad_sch, power.kicad_sch]
2026-09-30 kicad: board synced with schematic, J21 removed
    Update PCB from Schematic plus manual deletion of the orphaned J21
    footprint; 152 footprints, all linked to schematic symbols.
    [aquaPCB.kicad_pcb]
2026-09-30 kicad: generated starting placement
    Zoned placement on the 100x100 mm board: terminals on all edges with
    wire entry outwards (top: module, IN1-4; right: 1-Wire, S1-S4; bottom:
    Q1-Q6; left: AIN3, BNC, headers, 12 V in), Pi Zero 2 W face-up and
    rotated 180 deg (header per official mechanical drawing), only flat SMD
    parts under it, pH front end next to the BNC, buck converter at the
    right end of the middle band (>= 26 mm from the pH input), one column
    per Q channel. No routing yet. DRC: no clearance errors; only the known
    J2 box-header vs. Zero-hole courtyard overlap, silkscreen cosmetics and
    unrouted nets.
    [aquaPCB.kicad_pcb]
2026-09-30 kicad: drop UART console and second 1-Wire terminal, tighten buck loop
    Schematic: J3 (UART console) and J20 (1-Wire 2) removed by minimal
    edits; Pi header pins 8/10 (GPIO14/15) marked no-connect. ERC clean,
    connectivity otherwise unchanged.
    Board: J3/J20 removed, S1-S4 moved up on the right edge, buck converter
    placed per TI layout guidance (D4 SW pad 2.8 mm and L1 SW pad 3.7 mm
    from U1-SW, input cap 3.5 mm from VIN, control parts away from SW;
    >= 25.9 mm to the pH input). DRC with schematic parity: only the known
    J2/Zero-hole overlap, silkscreen and unrouted nets.
    Docs: 1 AKL 101-03 less, 35 header pins, cost ~40 EUR/board at 5.
    [aquaPCB.kicad_pcb, io.kicad_sch, pi.kicad_sch]
2026-09-30 kicad: right-angle BNC (LCSC C49352232) at the board edge
    New project footprint BNC_HanElectricity_BNC-Q9-50KWE_Horizontal, made
    from the LCSC/EasyEDA pad data and the maker drawing: pad 1 = centre
    contact on the axis, pad 2 = shell pin and both mounting legs; body
    front face on the board edge, barrel protrudes 21.4 mm. J25 swapped on
    the board with nets and schematic link kept (front face at x = 0).
    ERC clean; DRC with schematic parity: no J25 findings besides unrouted
    nets. Docs: BNC sourced from LCSC, shell = PH_SHELL (insulate from a
    metal enclosure), insulation resistance only >= 5 GOhm; cost ~39 EUR.
    [analog.kicad_sch, aquaPCB.kicad_pcb]
2026-09-30 kicad: simple 3D model for the right-angle BNC
    VRML model (mesh prisms; KiCad's VRML reader ignores Cylinder nodes) of
    the HanElectricity BNC-Q9-50KWE from the maker drawing: body on the
    board, nut/thread and barrel beyond the board edge, bayonet pins, legs
    and pins. Axis height 5.75 mm assumed (middle of the 11.5 mm body).
    Linked via ${KIPRJMOD} in the library footprint and on J25.
    [aquaPCB.kicad_pcb]
2026-09-30 kicad: BNC 3D model with outward-facing polygons
    KiCad ignores "solid FALSE" and culls back faces; the mixed polygon
    winding let the viewer look into the body. Every face is now oriented
    counter-clockwise seen from outside (normal away from the part centre).
2026-09-30 kicad: buck output caps right next to L1
    C8 moved directly beside the L1 +5V pad (3.0 mm, was 11 mm), C9 below
    it (5.3 mm); JP2 moved down to make room. DRC unchanged (known J2/Zero
    hole overlap, silkscreen, unrouted nets).
    [aquaPCB.kicad_pcb]
2026-09-30 kicad: mark optional headers as DNP
    J10 (ULN spare), J23 (2nd I2C), J24 (display) and JP3 (backlight) get
    the Do-Not-Populate flag in schematic and board. Footprints stay; BOM
    and pick-and-place exports with --exclude-dnp leave them out (checked:
    150 -> 146 parts). ERC clean, DRC unchanged. README: new "Build
    options" section; BOM: header/jumper counts.
    [aquaPCB.kicad_pcb, io.kicad_sch, ssr.kicad_sch]
2026-09-30 kicad: push-in spring terminals (Kangnex WJ250B), 8 A total
    All 18 screw terminals replaced by Ningbo Kangnex WJ250B push-in spring
    terminals (LCSC C8454 2-pole, C8420 3-pole; 3.5 mm pitch, staggered
    pins, 8 A IEC). New footprints from the EasyEDA pad data and the maker
    drawing (wire entry on the pin-1 side, facing the board edge) and
    simple 3D models. Board total current reduced to 8 A: fuse 8 A
    (Littelfuse 0154008.DR, LCSC C206919). Board: footprints swapped with
    nets and schematic links kept, edges re-placed for the deeper bodies.
    ERC 0; DRC unchanged (known J2/Zero-hole overlap, silk, unrouted).
    Docs: BOM/README (8 A budget, 5.3 mm input path, cost ~35 EUR/board).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
    [analog.kicad_sch, aquaPCB.kicad_pcb, io.kicad_sch, outputs.kicad_sch, power.kicad_sch, ssr.kicad_sch]
2026-09-30 kicad: terminal footprints accept Kangnex and MAX spring terminals
    Both suppliers make the same 3.5 mm push-in terminal with opposite
    stagger phase (Kangnex WJ250B: pole 1 in the front row, MAX MX250-B:
    pole 1 in the back row; same body, wire entry on the same face). The
    footprints now have a hole in both rows for every pole (drill 1.2 mm),
    so either part fits the same spot. Board terminals updated with nets
    and positions kept; both holes of a pole must be joined when routing.
    BOM/README: MAX C7470116/C7470117 listed as alternatives.
    [aquaPCB.kicad_pcb]
2026-09-30 BOM: list DORABO DB250S as third terminal alternative (entry side unverified)
2026-09-30 kicad: GND plane, keep-outs, net classes and first routing (by hand)
    State as saved in KiCad by the user; committed before review.
    [aquaPCB.kicad_pcb]
2026-09-30 kicad: correct keep-out rule areas
    - rule areas no longer forbid pads (fixes 8 DRC errors at H1-H4, J25)
    - BNC area: GND pour keep-out only, so the PH_BUF guard ring can be
    routed there
    - H3/H4 keep-outs on both layers like H1/H2; duplicate H1 area removed
    - new F.Cu keep-outs (d 6 mm) around the Pi Zero standoff holes H5-H8
    [aquaPCB.kicad_pcb]
2026-10-01 kicad: routing progress (by hand)
    [aquaPCB.kicad_pcb]
2026-10-01 kicad: Analog net class only for the high-impedance pH nets
    Drop the */PH_* and */AIN? patterns: PH_SIG, PH_REF, PH_BUF and AIN2/3
    are buffered or low-impedance, and the 0.5 mm Analog clearance cannot
    be met at the ADS1115's 0.5 mm pin pitch (4 DRC violations). Analog
    keeps Net-(U6A-+) and Net-(J25-*) (BNC centre and shell).
2026-10-01 kicad: guard ring around the pH input, keep-out trimmed, stub removed
    - PH_BUF guard zones on F.Cu and B.Cu around the high-impedance node
    (BNC centre, R45, C14 pin 1, U6 pin 3), priority above the GND plane,
    0.3 mm clearance (0.5 mm to the Analog nets); top islands stitched to
    the bottom guard with 5 vias plus one joining via near U6
    - BNC pour keep-out trimmed to the shell pin and mounting legs so it no
    longer blocks the guard fill
    - dangling 0.08 mm VIN stub removed
    DRC with refilled zones: no clearance, hole or dangling findings.
    [aquaPCB.kicad_pcb]
2026-10-02 kicad: drop J10, fix S1 output shorted to SSR_V
    - J10 (ULN2803 spare header) removed from schematic and board; the four
    unused ULN channels (U4 pins 5-8, 11-14) are marked no-connect
    - schematic: a wire in front of J11 joined its two stubs, shorting the
    S1 output (U4 O1, D18, J11 pin 2) to SSR_V; removed. The board carried
    the merged net too but no copper joined both sides; pads and tracks
    are split again (SSR side now Net-(J11-Pin_1), S1 side Net-(D18-K))
    - dangling 1.27 mm wire at R14 (outputs sheet) removed
    ERC 0; DRC with schematic parity: only the known J2/Zero-hole overlap
    and unrouted nets. Docs: J10 removed from README/BOM.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
    [aquaPCB.kicad_pcb, outputs.kicad_sch, ssr.kicad_sch]
2026-10-02 kicad: restore net names lost while tidying the schematic
    27 local labels re-added (Q1-Q6 _OUT/_G/_LED, S1-S4 _OUT/_LED, SSR_V);
    the board nets are renamed with all pads and tracks. Connectivity is
    unchanged, ERC 0, DRC with schematic parity clean. Q?_OUT match the
    "Power" net class pattern again.
    [aquaPCB.kicad_pcb, outputs.kicad_sch, ssr.kicad_sch]
2026-10-03 kicad: GND vias for all top-side ground pads
    71 GND vias (0.6/0.3 mm) with short tracks to the bottom GND plane:
    4 per MOSFET source (Q1-Q6, 0.8 mm tracks), 2 each at the buck input
    caps C2-C4, catch diode D4 and TVS D2, 1 each at the remaining SMD
    ground pads (pull-downs, LEDs, decoupling, U2/U3/U4/U6 GND pins).
    U1 pin 7 joined to its thermal pad. Placed with clearance checks
    against all other copper, guard zones, keep-outs, holes and the edge.
    All GND pads now reach the plane; DRC unchanged otherwise
    (unrouted: 157 -> 108).
    [aquaPCB.kicad_pcb]
2026-10-03 kicad: remove GND vias except at the MOSFET sources
    Undo 47 of the 71 vias from d81bb8b (with their tracks); the 4 vias per
    source pad of Q1-Q6 and the U1 pin 7 -> thermal pad link stay.
    DRC: no errors; the affected GND pads are unrouted again (150 open).
    [aquaPCB.kicad_pcb]
2026-10-03 kicad: reorder 74HCT244 channels for crossing-free Pi -> driver routing
    Inputs enter U3 from outside (pull-downs R8..R13 as a staircase), outputs
    leave inside under the IC body towards Q1..Q6. The GPIO order on the Pi
    header then has to be Q6..Q1, so the stage mapping changes to
    Q2 = GPIO12, Q3 = GPIO13, Q4 = GPIO19 (hardware PWM stays on GPIO18/19,
    now Q1/Q4). Unused channels: pin 8/11 inputs to GND, pin 9/12 open.
    [aquaPCB.kicad_pcb, outputs.kicad_sch, pi.kicad_sch]
2026-10-05 kicad: remove dangling Q5/Q6_DRV stubs and unconnected +5V via
    [aquaPCB.kicad_pcb]
2026-10-05 kicad: move C1, routing improvements (by hand)
    [aquaPCB.kicad_pcb]
2026-10-05 kicad: extended ground/VIN rework attempt (by hand)
    [aquaPCB.kicad_pcb]
2026-10-05 kicad: remove leftover stubs, no-net tracks and unconnected vias
    [aquaPCB.kicad_pcb]
2026-10-05 kicad: regular 2x3 source-via blocks with F.Cu GND areas at Q1..Q6
    Replaces the 8 crowded vias per MOSFET source (6 hole_to_hole violations)
    with 6 vias 0.3/0.6 on a 1 mm grid next to the source pad, joined to the
    pad by a small solid F.Cu GND zone (SRC_Qn, priority 2).
    [aquaPCB.kicad_pcb]
2026-10-05 kicad: swap J1 pins (pin 1 = GND), remove floating GND islands
    J1 GND now sits on the lower pole, so the ground plane leaves the input
    terminal directly east towards Q1..Q6 instead of being boxed in by the
    VIN_RAW B.Cu feed. VIN_RAW now starts at the upper pole (3 mm on both
    layers as before). Schematic: J1 rotated 180 deg instead of mirrored, wiring
    unchanged. GND B.Cu zone island removal set to "always" (removes the
    floating 1.05 mm2 island next to J1).
    [aquaPCB.kicad_pcb, power.kicad_sch]
2026-10-05 kicad: J1 polarity silk (+12V/GND), connector values match aquaPi port names
    Terminal values now use the IoRegistry port names (PWM 0/1, GPIO n,
    DS1820, ADC #1 in n) instead of the old "OUT G18"-style labels, several of
    which were stale after the 74HCT244 reorder. Values stay on F.Fab; only the
    J1 polarity marks are added to the silkscreen.
    [analog.kicad_sch, aquaPCB.kicad_pcb, io.kicad_sch, outputs.kicad_sch, ssr.kicad_sch]
2026-10-05 kicad: layout tweaks (by hand)
    [aquaPCB.kicad_pcb]
2026-10-05 kicad: port-name labels on silk for Q1..Q6, S1..S4, 1-Wire and pH terminals
    0.8 mm text, 0.15 mm stroke, placed tight next to (rows) or in front of
    (columns) the own terminal body, clearly away from the neighbours. Terminal
    refs of these connectors moved to F.Fab. Top row (IN1..4, module) and J27
    have no unambiguous spot and keep their value on F.Fab.
    [aquaPCB.kicad_pcb]
2026-10-05 kicad: shorten D3/D5 values in schematic to match the board (PWR, 3V3)
    [power.kicad_sch]
2026-10-05 kicad: move 22 conflicting reference texts next to their parts
    Only references that overlapped pads or other silkscreen were moved, each
    kept within 0.5 mm of its own courtyard and closer to it than to any other
    part; five resistor refs reduced to 0.8 mm. Silkscreen DRC items 90 -> 39.
    [aquaPCB.kicad_pcb]
2026-10-05 kicad: add board title "aquaPCB v1.0 / (c) 2026 Markus Kuhn" bottom right
    [aquaPCB.kicad_pcb]
2026-10-05 kicad: group headings for load/SSR outputs, bottom-silk "+" at positive poles
    Top silk: "LOAD OUT max 5A" at the end of the Q1..Q6 terminal row,
    "SSR CTRL max 0.5A" below the S1..S4 column. Bottom silk: "+" next to the
    positive pole of J1, J4..J9 (VIN) and J11..J14 (SSR_V). Coloured variants of
    the push-in terminals are not available at LCSC (grey only).
    [aquaPCB.kicad_pcb]
2026-10-05 kicad: repeat connector labels on the bottom silkscreen
    Each connector's value (aquaPi port name) mirrored on B.SilkS, centred
    between its pins; single-row headers (I2C, display) and the BNC get the
    label next to their own pins. No new DRC items.
    [aquaPCB.kicad_pcb]
2026-10-05 kicad: drop Pi Zero holes next to the header, J19 value from board to schematic
    H7/H8 and their standoff keep-outs removed: the box header no longer
    collides with them (last DRC errors gone), the Zero's header side is held by
    the plug connection and its outer side by H5/H6. J19 value "1-wire\nDS1820"
    taken over from the board. README/BOM: 2 standoffs instead of 4.
    [aquaPCB.kicad_pcb, io.kicad_sch, pi.kicad_sch]
2026-10-05 kicad: silk tweaks (by hand)
    [aquaPCB.kicad_pcb]
2026-10-05 kicad: bottom-silk pole marks next to the pole's own pins (SSR, 1-Wire, ADC in)
    SSR "+" moved out of the port-label line to the SSR_V row; new "+"/"GND"
    marks for J19 (1-Wire) and the ADC inputs J26/J27.
    [aquaPCB.kicad_pcb]
2026-10-05 kicad: resolve remaining silkscreen conflicts (DRC now clean)
    Group bracket lines moved off the diode outlines (LOAD) and below the SSR
    heading (SSR, vertical straightened), 0.15 mm width. Refs of J15..J18 to F.Fab
    like the other labelled terminals; H4/Q4 refs moved next to their parts;
    refs of C19, D11, D27, R15, R27, R30, R31, R46, R48, R52 have no free spot
    near the part and moved to F.Fab.
    [aquaPCB.kicad_pcb]
2026-10-05 kicad: bottom-silk +3V3/GND marks for the inputs IN1..IN4 (J15..J18)
    [aquaPCB.kicad_pcb]
2026-10-05 kicad: voltage marks instead of "+" at J19 (+3V3), J26 (+5V), J27 (+3V3)
    [aquaPCB.kicad_pcb]
2026-10-05 kicad: I2C pin names (GND/3V3/SCL/SDA) on the bottom silk between J22 and J23
    [aquaPCB.kicad_pcb]
2026-10-05 kicad: schematic re-save (library symbol refresh, BOM field setup)
    [analog.kicad_sch, io.kicad_sch, outputs.kicad_sch, pi.kicad_sch, power.kicad_sch, ssr.kicad_sch]
2026-10-10 docs: compare with Robo-Tank/Leviathan, recommended v2 improvements
    COMPARISON.md: aquaPCB v1 vs Robo-Tank Deluxe, Leviathan and the open
    reef-pi HAT. README: v2 candidates - silk labels matching aquaPi board
    profiles, ID EEPROM, RTC, pluggable wiring, 0-10 V add-on, isolated pH
    option, ready-to-use offer.
2026-10-10 docs: source location for CERN-OHL-S, BOM is v1 final
2026-10-10 README: isolated pH as an optional add-on module (AMC3311)
    Block design checked against the AMC3311 and TLV9062 data sheets: the
    AMC3311's isolated HLDO supply (4 mA at VDD >= 3.6 V) powers buffer and
    bias reference; the difference amp sits on the low side and feeds one
    ADS1115 input via the existing module input. Noise from the integrated
    DC/DC next to the electrode is the risk to measure on a prototype.
2026-10-10 README: v2 decision - pH/ORP amplifiers move to add-on modules
    The v2 main board drops its pH front end and offers add-on sockets on the
    ADS1115 inputs. Two modules: non-isolated (v1 front end incl. the 1 MOhm
    ground-loop resistor) and isolated (AMC3311). Both serve pH and ORP via a
    bias option; EC needs a different circuit and stays a bought module.
2026-10-10 README: ORP add-on bias ~0.7 V, not 1.0 V
    ORP is mostly positive (aquarium +150..+450 mV) rather than centred on
    0 mV like pH, so a lower bias uses the AMC3311 input range better.
    Also note the different calibration (pH 2-point, ORP offset only).
2026-10-10 README: one bias (1.2 V) for pH and ORP add-ons
    The pH bias already covers aquarium ORP (-1.3..+0.8 V measurable,
    aquarium +150..+450 mV), so no bias option or second variant is needed;
    only the calibration differs.
2026-10-10 README: v2 has four identical analog sockets, no reference input
    v1's AIN1 monitored the on-board pH bias; on v2 the bias lives on the
    add-on, so all four ADS1115 inputs get the same +5 V / SIG / GND socket
    with a 10k/20k divider (0-5 V), RC filter and clamp.
2026-10-10 README: v2 drops S1..S4/ULN2803, Q2/3/5/6 on PCA LED channels, v1->v2 summary
    SSRs and relay coils go on the 5 A Q outputs instead of the ULN2803.
    Q2/Q3/Q5/Q6 share PCA #1 LED channels 15..12 (dimmable power outputs
    for new users, LED RJ45 for Robo-Tank owners), freeing 8 GPIOs for the
    sensor inputs. New section lists every port v1 -> v2 with aquaPi port
    names, and the dropped/added active parts.
2026-10-10 README: v2 keeps a single 1-Wire terminal
    One bus on GPIO 4 takes both Robo-Tank temperature probes in the same
    terminal; no second terminal, no second 1-Wire overlay.
2026-10-10 README: v2 allows push-in terminals anywhere outside the Pi area
    Inside the board they need top-entry terminals; edge positions keep the
    side-entry WJ250B. Freed edge length should keep v2 at 100 x 100 mm.
2026-10-13 AGENTS.md: agent context, hardware/software session split, KiCad and branch rules
2026-10-13 kicad-v1: read-only copy of the v1 KiCad project for side-by-side viewing
    [analog.kicad_sch, aquaPCB.kicad_pcb, aquaPCB.kicad_sch, io.kicad_sch, outputs.kicad_sch, pi.kicad_sch, power.kicad_sch, ssr.kicad_sch]
2026-10-13 kicad: strip obsolete v1 parts for v2 (SSR sheet, IN1..IN4, pH front end)
    41 parts, their tracks/vias, pH guard zones, BNC keep-out and port silk removed; freed J2/U5 pins marked no-connect. ERC 0, DRC 0, parity 0; one expected +3V3 ratsnest to J24/JP3/J27/D28 left for the v2 layout.
    [analog.kicad_sch, aquaPCB.kicad_pcb, aquaPCB.kicad_sch, io.kicad_sch, pi.kicad_sch, ssr.kicad_sch]
2026-10-13 kicad: remove +3V3 routing for the v2 re-layout
    Change made by hand in pcbnew (25 tracks, 2 vias on +3V3); committed on request before the v2 schematic work.
    [aquaPCB.kicad_pcb]
2026-10-14 kicad: v2 schematic and board update (PCA9685 x2, box-header ports, sensors, analog sockets)
    New sheets pwm/powerbar/sensors; Q2/3/5/6 on PCA #1 ch 15-12; sensor GPIOs 5,6,20,21,22,23; 1-Wire +5V_EXT/Data/GND; four identical 0-5 V analog sockets; DC/LED/sensor ports as 2x4 box headers (pin n = Robo-Tank v3 RJ45 pin n). Board: 82 new footprints coarse-placed (56 parked beside the board), ERC 0, DRC copper 0, parity 0. README v2 plan updated.
    [analog.kicad_sch, aquaPCB.kicad_pcb, aquaPCB.kicad_sch, io.kicad_sch, outputs.kicad_sch, pi.kicad_sch, powerbar.kicad_sch, pwm.kicad_sch]
2026-10-14 kicad: v2 space measures - feeder on power bar header, resistor arrays, 0603, TSSOP buffers
    Feeder port dropped: power bar header pin 10 = +3V3_EXT (own AMS1117), any PCA #2 channel as signal; 30 series resistors as 8x 4x0603 arrays; new passives 0603; new 74HCT244 in TSSOP-20; flat parts may use the Pi zone, connectors anywhere else. ERC 0, DRC copper 0, parity 0.
    [analog.kicad_sch, aquaPCB.kicad_pcb, aquaPCB.kicad_sch, io.kicad_sch, pi.kicad_sch, powerbar.kicad_sch, pwm.kicad_sch, sensors.kicad_sch]
2026-10-14 kicad: prepare v2 re-layout - keep and lock power section, remove signal routing
    Power section (input protection, buck, 3V3 LDO, U3 gate driver, Q1-Q6, J4-J9, J2, holes) kept and locked: 71 footprints, 537 tracks/vias, 7 zones. Signal routing removed (241 tracks, 23 vias); 93 footprints incl. all LEDs free for re-placement. DRC copper 0, parity 0.
    [aquaPCB.kicad_pcb]
2026-10-14 kicad: pin headers for 1-Wire, ADC and floats; connectivity-driven re-placement
    J19, ADC sockets (J36/J37/J26/J27, 3x4 grid) and floats J30/J31 are pin headers now. All footprints placed on the board (big connectors first, flat parts allowed under the Pi, user-placed U10/RN5/J32/U11 and user routing kept): signal ratsnest 7824 -> 4450 mm, crossings 1776 -> 862. ERC 0, DRC copper 0, parity 0.
    [analog.kicad_sch, aquaPCB.kicad_pcb, aquaPCB.kicad_sch, io.kicad_sch, pi.kicad_sch, power.kicad_sch, powerbar.kicad_sch, pwm.kicad_sch]
2026-10-14 kicad: unrouted parts moved off-board into function groups for manual placement
    Includes the user's push&shove routing. 92 unlocked, unrouted footprints placed right of the board as 8 KiCad groups (PWM #1, power bars, ADC, sensors, 1-Wire/I2C/display, Q LEDs, power LEDs, +3V3_EXT regulator) in signal-flow rows; routed/locked parts unchanged. DRC 0 violations, parity 0.
    [aquaPCB.kicad_pcb]
2026-10-16 kicad: power bar group re-placed and routed, 5 V I2C removed
    - Power bars: U10 rotated, RN5..RN8 re-placed, J32/J33 rotated by 180 deg
    (pinout unchanged). Original PCA #2 channel order kept (bar 1 outlet n =
    ch n-1, bar 2 = ch n+7); identical array elements re-assigned in the
    schematic for routing. All power bar nets routed, U10 supply re-done,
    SDA/SCL escape stubs towards the Pi header.
    - Sensors: 5 V I2C (PCA9306, J35) removed, I2C is 3.3 V only.
    - Board: manual group placement and routing, Q4_DRV clearance fix,
    duplicate via and dangling GND stubs removed.
    - README: 5 V I2C note and PCA #2 channel order / rotated headers.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
    [aquaPCB.kicad_pcb, aquaPCB.kicad_sch, powerbar.kicad_sch, sensors.kicad_sch]
2026-10-22 kicad: PWM #1 group placed and routed, supply and signal routing
    - PWM #1 (PCA9685 #1, 74HCT244 buffers, RN1..RN4, DC/LED ports): placed
    on the board clear of the Pi mounting hole H5, J29 fully on the board;
    all internal nets routed. Identical buffer gates and array elements
    re-assigned to cut crossings (PCA9685 channel -> port unchanged);
    pwm.kicad_sch relaid out with a label stub per buffer/array pin.
    - Floats: J30/J31 and R53/R54 swapped, re-routed.
    - Routing of +3V3, +3V3_EXT, +5V_EXT, I2C, sensor inputs and the PCA1
    CH12..15 links to the power section.
    - Fixes: PCA1_CH14 break closed, stray vias/stubs removed, clearance
    violations at J2, R7 and along SDA resolved, J32 pin 9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
    [aquaPCB.kicad_pcb, pwm.kicad_sch]
2026-10-23 kicad: v2 layout finished - ADC renumbering, port labels, last routes
    - ADC sockets numbered 0..3 from right to left; AIN0<->AIN1 and AIN2<->AIN3
    swapped at the ADS1115, U5 end runs re-routed.
    - Connector labels: IoRegistry-style port names (PCA#1 chNN, ADC #1 in n,
    GPIO n, DS1820); J5/J6/J8/J9 corrected from GPIO to PCA#1 ch15/14/13/12
    (also in outputs.kicad_sch). Back side: names with voltage/current
    ratings, running from the board edge at pin 1, "+" on supply pins,
    SCL/SDA and 1-Wire Data marks. Front: ADC #1 / in n, jumper labels.
    - Routed the last six open nets (+3V3 at J24/JP4, +5V_EXT at J19,
    GPIO2_SDA J22-J23 on B.Cu, AIN1, J24 pin 10 - JP3, PCA1_CH1); PCA1_CH3
    partly m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
    [analog.kicad_sch, aquaPCB.kicad_pcb, outputs.kicad_sch, power.kicad_sch, powerbar.kicad_sch, pwm.kicad_sch, sensors.kicad_sch]
2026-10-23 README: v2 status, key figures and Robo-Tank port-by-port mapping
    - Intro, status and key figures describe v2 (layout complete on main);
    v1-only sections are marked as such and link to the v2 sections.
    - New "Port by port" section: Robo-Tank v3 vs aquaPCB v2 per port, checked
    against the v3 manual and the netlist - DC/LED identical, power bars move
    from Pi GPIOs to PCA9685 #2, crossed backup floats on v3, different
    sensor GPIOs, feeder, temperature, I2C and power-in differences.
    - v2 plan header and roadmap updated; AGENTS.md: v2 DRC state and the
    kicad_dru rule; BOM.md and COMPARISON.md marked as v1.
2026-10-23 kicad: LCSC numbers for PCA9685 and PTC, status LED names follow PCA#1
    - U7/U10 PCA9685PW,118 -> LCSC C2678753, F2 nSMD050 -> C69688 (schematic
    and board), so every assembled part carries an LCSC number.
    - Status LEDs D9/D11/D15/D17 renamed GPIO12/13/16/26 -> PCA#1 ch15/14/13/12,
    matching the Q2/Q3/Q5/Q6 drive since v2.
    [aquaPCB.kicad_pcb, outputs.kicad_sch, powerbar.kicad_sch, pwm.kicad_sch, sensors.kicad_sch]
2026-10-23 BOM: v2 bill of materials, README cost estimate and header wording
    - BOM.md is now the v2 BOM: prices/stock from the JLCPCB parts API
    (2026-10-23), SMD $15.15 + LCSC THT $3.32 + Reichelt ~EUR 2.50 per board,
    13 extended parts; box headers from LCSC (Reichelt has no 2x4), changes
    from v1 and rejected options listed.
    - README cost estimate for v2: ~EUR 40 at batch 5, ~EUR 31 at batch 10.
    - v2 docs: 1-Wire and backup floats are pin headers, not terminals; unused
    float inputs are bridged with jumper shunts (added to the BOM).
2026-10-23 BOM: note blind-pin keying option and 2x5 box header fallback
2026-10-23 fab: JLCPCB outputs for v2 and tools/fab.sh to rebuild them
    - fab/gerbers: 9 Gerber layers (Protel extensions, no X2), PTH/NPTH
    Excellon drill files with maps, job file.
    - fab/aquaPCB-bom-jlc.csv + aquaPCB-cpl-jlc.csv: 125 SMD parts (top, no DNP),
    counts per LCSC number match BOM.md.
    - fab/aquaPCB-print-1to1.pdf: A4, scale 1, for the footprint print check.
    - tools/fab.sh: refuses to build on ERC/DRC errors or SMD parts without an
    LCSC number; the upload zip (aquaPCB-gerbers.zip) stays untracked.
    Part rotations in the CPL still need a check in JLC's placement preview.
    [aquaPCB-B_Cu.gbl, aquaPCB-B_Mask.gbs, aquaPCB-B_Paste.gbp, aquaPCB-B_Silkscreen.gbo, aquaPCB-Edge_Cuts.gm1, aquaPCB-F_Cu.gtl, aquaPCB-F_Mask.gts, aquaPCB-F_Paste.gtp]
2026-10-24 kicad: current paths and thermal fixes in the power section
    - 10 VIN vias at the Q10 source (was 6); SW node and 5V_PI widened to 1.5 mm;
    F1 -> Q10 drain widened to 5.5 mm.
    - J1 GND pads: local thermal spoke width 1.0 mm (7 spokes into the B.Cu GND plane).
    - Q10 drain copper zone (Q10_DRAIN, F.Cu, ~1.25 cm2) for Q10 and the fuse holder.
    - Q10 AOD4185 -> DMP4010SK3Q-13 (9.9 mOhm, same DPAK pinout); F1 8 A -> 10 A insert
    (0154010.DR, same holder); F2 PTC 0.5 A -> nSMD110 (1.1 A hold) since the feeder
    shares +5V_EXT.
    - B.Cu solder mask opening over the VIN trunk to J4 (optional hand tinning).
    - Silkscreen: "max 5A, total 6.5A" on both sides; "12V IN" label nudged off the opening.
    ERC cle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
    [aquaPCB.kicad_pcb, power.kicad_sch, sensors.kicad_sch]
2026-10-24 fab: JLC rotation corrections, regenerated outputs
    - tools/fab.sh: per-LCSC rotation offsets KiCad -> JLC, checked against the EasyEDA
    footprints (pin 1 / cathode / tab): +270 for SOIC/TSSOP/MSOP and the resistor
    arrays, +180 for SOT-23, SOT-223 and the DPAK P-FET.
    - fab/: Gerbers, drill, JLC BOM and CPL regenerated for the power-section changes.
    [aquaPCB-B_Cu.gbl, aquaPCB-B_Mask.gbs, aquaPCB-B_Paste.gbp, aquaPCB-B_Silkscreen.gbo, aquaPCB-Edge_Cuts.gm1, aquaPCB-F_Cu.gtl, aquaPCB-F_Mask.gts, aquaPCB-F_Paste.gtp]
2026-10-24 README, BOM: current budget, component temperatures, Pi 4/5 supply
    - Current budget for v2: only the 5 V buck draws from VIN besides Q1..Q6; outputs
    6.5 A total (7.7 A typical / 7.0 A / 6.5 A depending on the 5 V load), copper
    table with IPC-2221 rise (target <= 10 C), component temperature estimates,
    fuse derating, PWM limit for inductive loads.
    - Pi 4/5 need their own supply (JP1 open); Pi Zero 2 W and Pi 3 run from the board.
    - BOM: DMP4010SK3Q-13, 10 A fuse insert, nSMD110 PTC; totals updated.
2026-10-24 kicad: GPIO18_Q1 re-routed, shorter and away from the buck
    The hardware PWM line for Q1 no longer loops past U1/D4 (x 137-140); it now runs
    directly via x 129-135, away from the switching node.
    [aquaPCB.kicad_pcb]
2026-10-24 fab: regenerated outputs for the GPIO18_Q1 re-route
    [aquaPCB-B_Cu.gbl, aquaPCB-B_Mask.gbs, aquaPCB-B_Paste.gbp, aquaPCB-B_Silkscreen.gbo, aquaPCB-Edge_Cuts.gm1, aquaPCB-F_Cu.gtl, aquaPCB-F_Mask.gts, aquaPCB-F_Paste.gtp]
2026-10-24 README: component temperatures at 12 V and 24 V
    Hotspot table per supply voltage (Q10/F1 at 12 V; D4 and U1 at 24 V), what to
    measure on the prototype and the options if it runs too warm.
2026-10-26 kicad: back silkscreen shows the LED port pin of Q2/Q3/Q5/Q6
    "PCA#1 ch15 ≙ LED 2" ... "PCA#1 ch12 ≙ LED 5" on J5/J6/J8/J9 - these outputs share
    their PCA #1 channel with LED port pins 2-5. Group label "max 5A, total 6.5A" moved
    up 2.7 mm to clear the longer labels.
    [aquaPCB.kicad_pcb]
2026-10-26 fab: regenerated outputs for the back silkscreen labels
    [aquaPCB-B_Cu.gbl, aquaPCB-B_Mask.gbs, aquaPCB-B_Paste.gbp, aquaPCB-B_Silkscreen.gbo, aquaPCB-Edge_Cuts.gm1, aquaPCB-F_Cu.gtl, aquaPCB-F_Mask.gts, aquaPCB-F_Paste.gtp]
2026-10-26 README: aquaPCB for reef-pi
    Port-by-port reef-pi setup checked against the reef-pi source: drivers (PCA9685
    0x40/0x41 as jacks or outlets, ADS1115 0x48, built-in Raspberry Pi driver),
    config.txt overlays, which control loops each port serves, and the caveats
    (power bar driver change, shared PCA #1 channels, sensor inputs without pull
    resistors, floats hardware-only, display without reef-pi driver).
